KhazAkar/espws/thesis/thesis.tex

\documentclass[12pt,a4paper,oneside]{memoir}
\usepackage{polski}
\usepackage[top=2.5cm, bottom=2.5cm, left=3.5cm, right=1cm]{geometry}
\usepackage{amsmath}
\usepackage{amsfonts}
\usepackage{amssymb}
\usepackage{graphicx}
\usepackage{titling}
\usepackage{titlesec}
\usepackage{fontspec}
\usepackage{siunitx}
\usepackage{caption}
\usepackage{multirow}
\usepackage{lscape}
\usepackage[table,xcdraw]{xcolor}
\usepackage{float}
\usepackage{pdfpages}
\usepackage{listings}
\usepackage[section]{placeins}
\usepackage[
bookmarks=false,
pdfpagelabels=false,
hyperfootnotes=false,
hyperindex=false,
pageanchor=false,
hidelinks
]{hyperref}
% Wykorzystywane źródła dla tego tekstu
% Usunięcie napisu "Rozdział"
\renewcommand{\chaptername}{} 
% Konwersja znaku mikro z matematyki na tekst
\sisetup{math-micro=\text{µ},text-micro=µ} 
% Ustawienie wcięć w paragrafach
% Ustawienie czcionki Arial 
\newfontfamily{\tytulyrozdzialow}{Arial} 
% Czionka TMR dla całego tekstu
\setmainfont{Times New Roman}
\titleformat
	{\chapter} % Formatowanie rozdziałów
	[hang] % Tekst obok liczby
	{\fontsize{14pt}{16pt}\bfseries\tytulyrozdzialow\flushleftright} % Regulacja czcionki rozdziałów
	{\chaptertitlename\ \thechapter.} % Ustawianie wyglądu nagłówków rozdziałów
	{15pt} % Odstęp między liczbą a tekstem
	{} 
\setsecheadstyle{\fontsize{13pt}{15pt}\tytulyrozdzialow\bfseries} % Ustawienie stylu dla sekcji

\definecolor{dkgreen}{rgb}{0,0.6,0}
\definecolor{gray}{rgb}{0.5,0.5,0.5}
\definecolor{mauve}{rgb}{0.58,0,0.82}

\lstset{frame=tb,
	language=C++,
	aboveskip=3mm,
	belowskip=3mm,
	showstringspaces=false,
	columns=flexible,
	basicstyle={\small\ttfamily},
	numbers=none,
	numberstyle=\tiny\color{gray},
	keywordstyle=\color{blue},
	commentstyle=\color{dkgreen},
	stringstyle=\color{mauve},
	breaklines=true,
	breakatwhitespace=true,
	tabsize=3
}
\begin{document}
\renewcommand{\maketitle}
{
	\centering
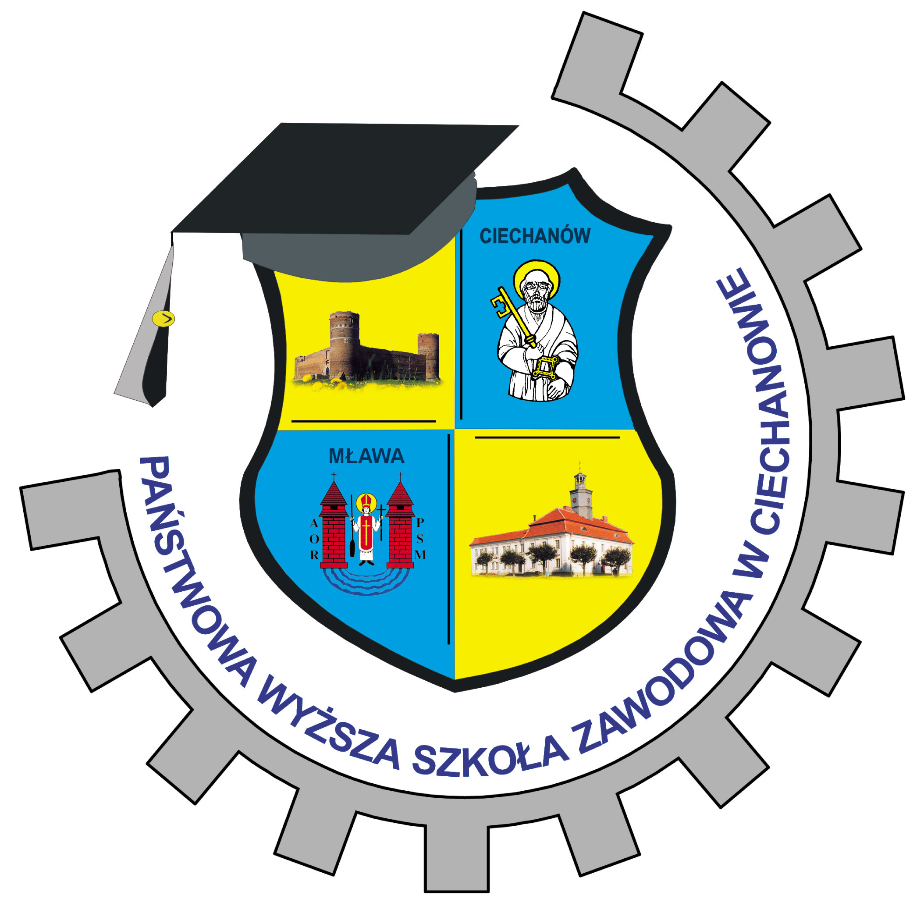
[picture p1: thesis/images/logo.jpg]
	\par\vspace{1cm}
	{\scshape\LARGE Kierunek: Elektronika i Telekomunikacja\\ Specjalność: Teleinformatyka \par}
	\vspace{1cm}
	{\scshape\Large Praca dyplomowa inżynierska\par}
	\vspace{1.5cm}
	{\huge\bfseries Stacja meteorologiczna oparta o ESP8266\par}
	\vspace{2cm}
	{\Large\itshape Damian Zaręba\\Nr albumu 8389\par}
	\vfill
	Promotor:\par
	dr inż. Tadeusz Leszczyński
	\vfill
	
	% Dół strony
	{\large Mława 2019r. \par}
}
\maketitle
\thispagestyle{empty}
\newpage
{\tytulyrozdzialow \tableofcontents}
\newpage
\flushleftright
\chapter{Wstęp}
	\hspace{\parindent} Celem pracy jest zaprojektowanie i zrealizowanie stacji meteorologicznej opartej o mikroprocesor ESP8266, złożonej z kilku modułów. Aby zrealizować założony cel, zrealizowane zostały następujące zadania:
	\begin{itemize}{}{}
		\item Zaprojektowanie i wykonanie płyty głównej z mikrokontrolerem ESP8266EX dla przetwarzania informacji z sensorów oraz sterowania zasilaniem całego urządzenia;
		\item Zaimplementowanie sensora firmy BOSCH o nazwie BME280, który służy do odczytu temperatury, ciśnienia i wilgotności powietrza;
		\item Zaimplementowanie czujnika firmy PLANTOWER o nazwie PMS7003, który mierzy ilość pyłu zawieszonego w powietrzu, o wielkości PM1.0 oraz PM10, mierzone w \si\micro g/m$^{3}$.
	\end{itemize}
	\par W kolejnych rozdziałach pracy przedstawiono schemat blokowy urządzenia oraz ogólny opis poszczególnych modułów wykorzystanych do zbudowania tego urządzenia, wliczając w to charakterystyki głównych komponentów dla każdego modułu. Udokumentowane zostało m.in. konfiguracja środowiska, które zostało wykorzystana do stworzenia tego projektu.
	\par Przeanalizowano szczegółowo schemat urządzenia, a konkretnie płyty głównej, sekcji zasilania dla wykorzystanych sensorów oraz innych elementów niezbędnych do realizacji projektu. Poddana dokładnej analizie będzie każda z części schematu, takie jak sekcja zasilania czy połączeniowa między płytą główną a sensorami.
	\par  W przedostatnim rozdziale przedstawiono i opisano algorytmy oraz kod źródłowy programu sterującego stacją pogodową oraz omówiono protokoły komunikacyjne. Wykonuje on wiele zadań, m.in. odczytuje dane z sensorów czy kontroluje układy zasilania poszczególnych części.
	\par W ostatnim rozdziale przedstawione zostały wyniki badań wykonanego modelu stacji pogodowej.

\chapter{Elementy składowe projektu} 
\section{ESP8266EX}
\par ESP8266EX to mikroukład z pełnym stosem TCP/IP oraz mikrokontrolerem wyprodukowanym przez Espressif w Szanghaju, Chiny.\\
Istnieje jego odmiana o nazwie ESP8285 z 1 MiB wbudowanej pamięci typu flash, co umożliwiało wykorzystanie go jako pojedynczego układu zdolnego do podłączenia się do sieci Wi-Fi, po podłączeniu zasilania. W odróżnieniu od rodziny mikrokontrolerów AVR nie może być zasilany napięciem 5V, jedynie 3.3 wolta.\\
\begin{figure}[h]
	\centering
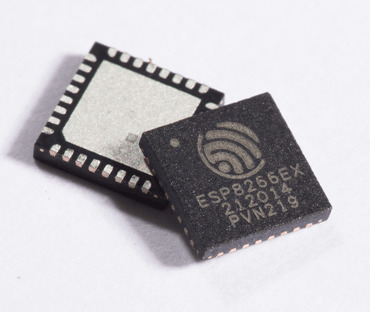
[picture p2: thesis/images/esp8266ex.jpg]
	
	{\tytulyrozdzialow \footnotesize \caption[ESP8266EX]{Zdjęcie przedstawiające układ ESP8266EX}
	\caption*{\textit{Źródło: \cite{esp8266chip}}}}
\end{figure}\\
\par ESP8266EX \cite{esp8266wiki} posiada 32 bitowy procesor oparty o rdzeń Xtensa Diamond Standard 106Micro (LX106) firmy Tensillica o nominalnej wartości zegara wynoszącym 80 MHz. Charakteryzuje się on następującymi funkcjami:
\begin{itemize}
	\item 16 pinów GPIO
	\item SPI
	\item I$^2$C (programowa implementacja)
	\item I$^2$S z funkcją Direct Memory Access (współdzieli piny z GPIO)
	\item UART na wyznaczonych pinach GPIO oraz dodatkowy UART na GPIO2 służący jedynie do wysyłania danych
	\item 10-bitowy ADC oparty o sukcesywną aproksymację.
	\item Wbudowana obsługa Wi-Fi o standardach b/g/n według IEEE 802.11 z wbudowanym przełącznikiem TR,LNA,Balunem, wzmacniaczem mocy oraz siecią dopasowującą oraz możliwością podłączenia się lub tworzenia sieci z zabezpieczeniami WEP lub WPA/WPA2
\end{itemize}
\par Pamięć ulotna tego mikrokontrolera jest podzielona w następujący sposób :
\begin{itemize}
	\item 32 KiB RAM dla instrukcji
	\item 32 KiB RAM typu cache dla instrukcji
	\item 80 KiB RAM dla danych użytkownika
	\item 16 KiB RAM typu ETS dla danych "systemowych"
\end{itemize}
\par Obsługuje pamięć nieulotną typu flash po protokole SPI do pojemności 16 MiB, choć zazwyczaj korzysta się z pamięci o rozmiarach 512 KiB lub 4 MiB.\\
\begin{figure}[h]
	\centering
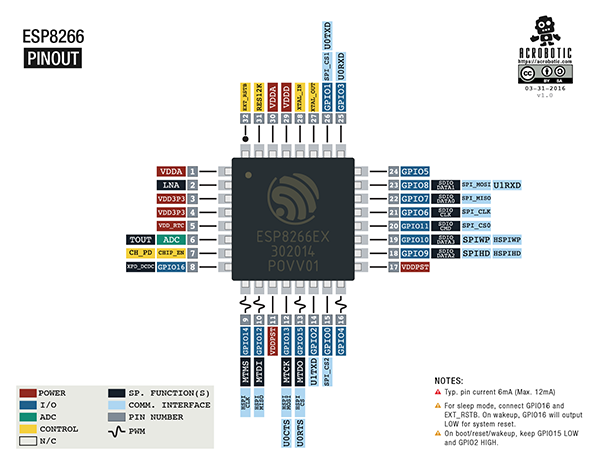
[picture p3: thesis/images/esp8266_pinout.png]
	
	{\tytulyrozdzialow \footnotesize \caption[ESP8266EX - opis wyprowadzeń]{Zdjęcie przedstawiające wyprowadzenia dla układu ESP8266EX}
	\caption*{\textit{Źródło: \cite{esp8266pinout}}}}
\end{figure}
\newpage
Układ ESP8266EX posiada kilka linii zasliania:
\begin{itemize}
	\item 2x VDDA (Zasilanie sekcji analogowej)- 2.5 wolt do 3.6 wolt
	\item VDDD (To samo, co VDDA) - 2.5 wolt do 3.6 wolt.
	\item 2x VDD3P3 (Zasilanie wzmacniacza sygnału Wi-Fi) - 2.5 wolt do 3.6 wolt.
	\item 2x VDDPST (Zasilanie sekcji cyfrowej i wejść/wyjść) - 1.8 wolt do 3.6 wolt.
\end{itemize}
\par Używa się pinów GPIO2, GPIO0 oraz GPIO15/MTDO dla ustawienia trybu uruchamiania układu.
\\[10pt]
\begin{table}[!h]
\centering
\resizebox{10cm}{!}{%
	\begin{tabular}{|
			>{\columncolor[HTML]{EFEFEF}}c |c|c|c|}
		\hline
		\cellcolor[HTML]{96FFFB} & \cellcolor[HTML]{EFEFEF}\textbf{GPIO0} & \cellcolor[HTML]{EFEFEF}\textbf{GPIO2} & \cellcolor[HTML]{EFEFEF}\textbf{GPIO15} \\ \hline
		\textbf{\begin{tabular}[c]{@{}c@{}}Tryb \\ programowania\end{tabular}} & L & H & L \\ \hline
		\textbf{\begin{tabular}[c]{@{}c@{}}Uruchamianie z\\ pamięci flash\end{tabular}} & H & H & L \\ \hline
		\textbf{\begin{tabular}[c]{@{}c@{}}Uruchamianie z\\ karty SD\end{tabular}} & X & X & H \\ \hline
	\end{tabular}%
}
	{\tytulyrozdzialow \footnotesize \caption[ESP8266EX - tryby uruchamiania]{Tabela przedstawiająca tryby uruchamiania dla układu ESP8266EX}
	\caption*{\textit{Źródło: \cite{esp8266datasheet}}}}
\end{table}\\
\newpage
\par ESP8266EX obsługuje 14 kanałów w łączności Wi-Fi
\begin{table} [!h]
\centering
\resizebox{6cm}{!}{%
	\begin{tabular}{|c|c|}
		\hline
		\rowcolor[HTML]{EFEFEF} 
		\textbf{\begin{tabular}[c]{@{}c@{}}Numer\\ kanału\end{tabular}} & \textbf{\begin{tabular}[c]{@{}c@{}}Częstotliwość\\ {[}MHz{]}\end{tabular}} \\ \hline
		1 & 2412 \\ \hline
		2 & 2417 \\ \hline
		3 & 2422 \\ \hline
		4 & 2427 \\ \hline
		5 & 2432 \\ \hline
		6 & 2437 \\ \hline
		7 & 2442 \\ \hline
		8 & 2447 \\ \hline
		9 & 2452 \\ \hline
		10 & 2457 \\ \hline
		11 & 2462 \\ \hline
		12 & 2467 \\ \hline
		13 & 2472 \\ \hline
		14 & 2484 \\ \hline
	\end{tabular}%
}
	{\tytulyrozdzialow \footnotesize \caption[ESP8266EX - kanały Wi-Fi]{Tabela przedstawiająca dostępne kanały łączności Wi-Fi dla układu ESP8266EX}
	\caption*{\textit{Źródło: \cite{esp8266datasheet}}}}
\end{table}\\
\newpage
\par Maksymalny pobór prądu przez sam układ, nie licząc łączności Wi-Fi wynosi 12mA.
Pobór wzrasta w zależności od mocy transmisji lub odbioru pakietów za pomocą Wi-Fi. Pomiary były wykonane dla napięcia 3 wolt w temperaturze 25$^°$C. Wszystkie pomiary przesyłu danych były bazowane na 50\% długości cyklu
\begin{table}[!h]
\centering
\resizebox{15cm}{!}{%
	\begin{tabular}{|
			>{\columncolor[HTML]{EFEFEF}}c |c|c|c|c|}
		\hline
		\textbf{\begin{tabular}[c]{@{}c@{}}Parametry \\ łączności\end{tabular}} & \cellcolor[HTML]{EFEFEF}\textbf{Minimalny} & \cellcolor[HTML]{EFEFEF}\textbf{Typowy} & \cellcolor[HTML]{EFEFEF}\textbf{Maksymalny} & \cellcolor[HTML]{EFEFEF}\textbf{Jednostka} \\ \hline
		\begin{tabular}[c]{@{}c@{}}TX 802.11b\\ CCK 11 Mbps\\ $P_{OUT}$ =\\ +15 dBm\end{tabular} & - & 170 & - & mA \\ \hline
		\begin{tabular}[c]{@{}c@{}}TX 802.11g\\ OFDM 54 Mbps\\ $P_{OUT}$=\\ +17 dBm\end{tabular} & - & 140 & - & mA \\ \hline
		\begin{tabular}[c]{@{}c@{}}TX 802.11n\\ MCS7\\ $P_{OUT}$ =\\ +13 dBm\end{tabular} & - & 120 & - & mA \\ \hline
		\begin{tabular}[c]{@{}c@{}}RX 802.11b\\ 1024 bajtów\\ -80 dBm\end{tabular} & - & 50 & - & mA \\ \hline
		\begin{tabular}[c]{@{}c@{}}RX 802.11g\\ 1024 bajtów\\ -70 dBm\end{tabular} & - & 56 & - & mA \\ \hline
		\begin{tabular}[c]{@{}c@{}}RX 802.11n\\ 1024 bajtów\\ -65 dBm\end{tabular} & - & 56 & - & mA \\ \hline
	\end{tabular}%
}
	{\tytulyrozdzialow \footnotesize \caption[ESP8266EX - pobór mocy przy łączności Wi-Fi]{Tabela przedstawiająca pobór mocy dla łączności Wi-Fi przez ESP8266EX}
	\caption*{\textit{Źródło: \cite{esp8266datasheet}}}}
\end{table}
\newpage
\section{BME280}
BME280 to sensor temperatury, wilgotności i ciśnienia wykonany przez firmę Bosch.
Jego rozmiary to 2.5 milimetra na 2.5 milimetra w obudowie typu LGA (Land Grid Array).
Komunikuje się z mikrokontrolerem za pomocą protokołu I$^2$C (Do 3.4 MHz) lub SPI (3 lub 4 przewodowego, do 10 MHz)
\begin{figure} [h]
	\centering
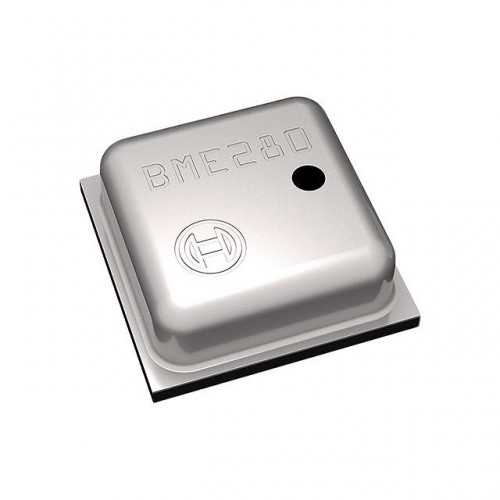
[picture p4: thesis/images/bme280.jpg]
	
	{\tytulyrozdzialow \footnotesize \caption[BME280]{Zdjęcie przedstawiające układ BME280}}
	\caption*{\textit{Źródło: \cite{bme280chip}}}
\end{figure}\\
Zasilany jest w projekcie napięciem 3.3V, choć jego specyfikacja podaje, że pin zasilania VDD samego układu toleruje napięcia od 1.71 wolt do 3.6 wolt, a pin zasilania wejść/wyjść VDDIO od 1.2 wolt do 3.6 wolt.\\*
\begin{figure} [h]
	\centering
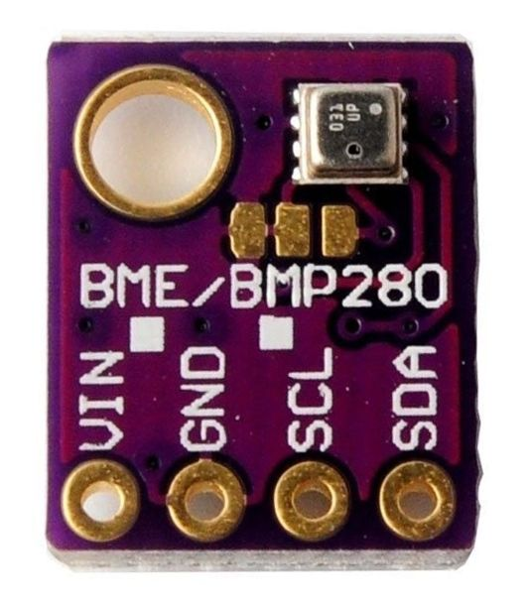
[picture p5: thesis/images/bme280-mod.jpg]
	
	{\tytulyrozdzialow \footnotesize \caption[BME280 - Moduł]{Zdjęcie przedstawiające moduł zawierający BME280, komunikujący się przez protokół I$^2$C}}
	\caption*{\textit{Źródło: \cite{bme280module}}}
\end{figure}\\
\newpage
Pobiera w zastosowanej aplikacji około 3.6µA, czyli pomiaru wilgotności, ciśnienia i temperatury z częstotliwością 1Hz, choć może być niższy, ponieważ pomiary będą dokonywane rzadziej, około co pół godziny lub godzinę, w zależności od wymagań. Będzie możliwość ustawienia tego w kodzie źródłowym programu dla tej aplikacji.\\[10pt]
Kluczowe parametry sensora wilgotności:
\begin{itemize}
	\item Czas odpowiedzi ($\tau_{63\%}$) wynosi 1 sekundę
	\item Tolerancja dla dokładności pomiaru wynosi ±3 \% relatywnej wilgotności
	\item Histereza pomiaru wynosi ±1 \% relatywnej wilgotności
\end{itemize}
Kluczowe parametry części pomiarowej dla ciśnienia:
\begin{itemize}
	\item Średni poziom szumów wynosi 0.2 Pa, co jest odpowiednkiem dla 1.7 cm
	\item Współczynnik odchylenia temperaturowego wynosi ±1.5 Pa/K, co jest równoważne dla ±12.6 cm przy zmianie temperatury o 1$^°$C
\end{itemize}
\newpage
\section{PMS7003}
Sensor PMS7003 służy do pomiaru ilości cząsteczek w powietrzu o gradiacji PM1.0, PM2.5 oraz PM10 (odpowiednio: cząsteczki o średnicy około 1µm, 2.5µm oraz 10µm). Powszechnie korzyta się z niego do pomiaru jakości powietrza. Wykorzystuje on do tego laserowy czujnik pyłków.
\begin{figure}[h]
	\centering
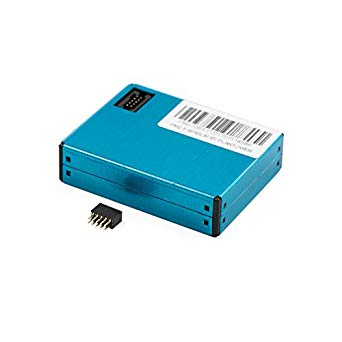
[picture p6: thesis/images/pms7003.jpg]
	
	{\tytulyrozdzialow \footnotesize \caption[PMS7003] {Zdjęcie przedstawiające moduł PMS7003, komunikujący się przez protokół UART}}
	\caption*{\textit{Źródło: \cite{pms7003module}}}
\end{figure}\\
Czujnik ten charakteryzuje się następującymi parametrami:
\begin{itemize}
	\item Pojedynczy czas odpowiedzi wynosi mniej niż 1s
	\item Całkowity czas odpowiedzi wynosi do 10 sekund
	\item Zasilany jest napięciem 5 wolt
	\item Pobór prądu podczas pomiarów wynosi do 100 mA
	\item Stały pobór prądu, kiedy czujnik nie wykonuje pomiaru wynosi do 200 μA
	\item Napięcie operacyjne dla przesyłu i odbioru danych to 3.3 wolta.
	\item Pracuje w temperaturze od -10 do +60 stopni Celcjusza.
	\item "Pojemność" czujnika wynosi 0.1L
\end{itemize}
\begin{figure}[ht]
	\centering
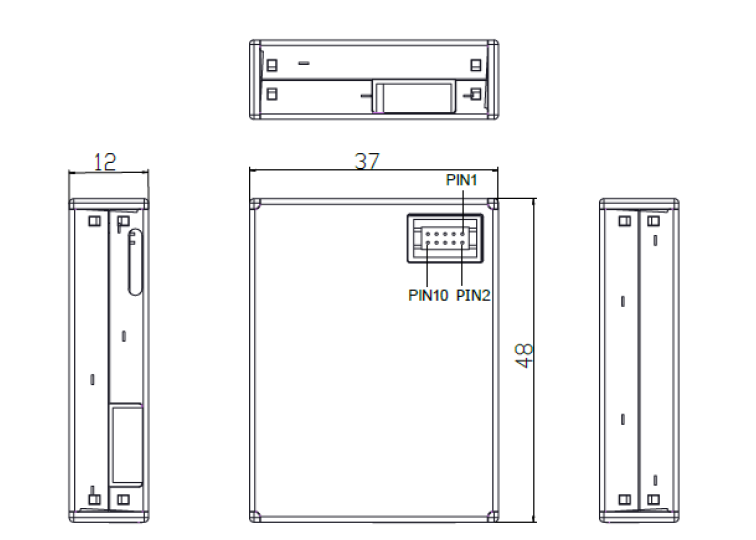
[picture p7: thesis/images/pms7003-pinout.png]
	
	{\tytulyrozdzialow \footnotesize \caption[PMS7003 - pinout] {Zdjęcie przedstawiające wyprowadzenia czujnika PMS7003}
	\caption*{\textit{Źródło: \cite{pms7003datasheet}}}}
\end{figure}
\newpage
Lista wyprowadzeń tego sensora jest następująca:
\begin{table}[h]
	\centering
	\resizebox{10cm}{!}{%
	\begin{tabular}{|c|c|c|}
		\hline
		\multicolumn{3}{|c|}{\cellcolor[HTML]{EFEFEF}\textbf{Wyprowadzenia PMS7003}} \\ \hline
		Pin 1 & VCC & Zasilanie 5V \\ \hline
		Pin 2 & VCC & Zasilanie 5V \\ \hline
		Pin 3 & GND & Masa zasilania \\ \hline
		Pin 4 & GND & Masa zasilania \\ \hline
		Pin 5 & RESET & Pin resetu modułu \\ \hline
		Pin 6 & NC & - \\ \hline
		Pin 7 & RX & Pin odbierania danych \\ \hline
		Pin 8 & NC & - \\ \hline
		Pin 9 & TX & Pin wysyłania danych \\ \hline
		Pin 10 & SET & \begin{tabular}[c]{@{}c@{}}Stan wysoki - normalna operacja\\ Stan niski - uśpienie układu\end{tabular} \\ \hline
	\end{tabular}%
}
	{\tytulyrozdzialow \footnotesize \caption[PMS7003 - Lista wyprowadzeń] {Tabela przedstawiająca listę wyprowadzeń modułu PMS7003}}
	\caption*{\textit{Źródło: \cite{pms7003datasheet}}}
\end{table}
\newpage
\chapter{Wykorzystane protokoły komunikacyjne}
\section{I$^2$C}
\par I$^2$C \cite{i2cwiki} to protokół szeregowy zaprojektowany przez firmę Phillips Semiconductor, która dziś działa jako NXP Semiconductors w 1982 roku. Ma możliwość podpięcia wielu urządzeń w trybie \textit{Master} oraz w trybie \textit{Slave}. Istnieją dwie dodatkowe wersje I$^2$C - SMBus (System Management Bus), wykorzystywany w komputerach klasy PC do zarządzania podzespołami oraz PMBus (Power Management Bus) - do kontroli urządzeń związanych z zasilaniem. 
\par Wykorzystuje on dwie obustronne linie z otwartym kolektorem lub otwartym drenem, Serial Data Line (SDA) i Serial Clock Line (SCL), z rezystorami podiągającymi do zasilania.Zazwyczaj używa się napięć +5V lub +3.3V, ale inne napięcia są również dozwolone.
\par Magistrala I$^2$C posiada kilka trybów prędkości:
\begin{itemize}
	\item Low-speed - 10 kbit/s
	\item Standard - 100 kbit/s
	\item Fast - 400 kbit/s
	\item Fast mode plus (Fm+) - 1 Mbit/s
	\item High speed - 3.4 Mbit/s
\end{itemize}
\par Z tych najszybszych korzysta się w systemach wbudowanych a nie w komputerach osobistych.\\
\par Magistrala I$^2$C posiada dwie ważne cechy - rozszerzanie zegara (Clock Stretching) oraz Arbitraż (Arbitation). 
Rozszerzanie zegara polaga na tym, że urządzenie typu \textit{Slave} może utrzymywać linię zegara SCL w stanie niskim po otrzymaniu lub wysłaniu bajtu informacji, która wskazuje, że nie jest jeszcze gotowe do przetwarzania kolejnej porcji danych. Urządzenie typu \textit{Master} komunikujące się z danym modułem nie może wtedy zakończyć transmisji tylko musi czekać aż linia zegara SCL będzie w stanie wysokim. Jest to jedyna sytuacja, gdzie urządzenie typu \textit{Slave} ma kontrolę nad linią zegara. Urządzenie typu \textit{Master} musi odczekać dodatkowe 4 μs po prześciu linii SCL w stan wysoki zanim będzie mógł podciągnąć linię zegara do stanu niskiego.
\par Magistrala I$^2$C posiada deterministyczny system arbitrażu. Arbitraż polega na tym, że każde urządzenie typu \textit{Master} monitoruje linię, wyszukując bitów START i STOP i nie zacznie komunikacji, póki linie są zajęte przez inne urządzenia typu \textit{Master}. Jednakże, dwa urządzenia typu \textit{Master} mogą zacząć transmisję w tym samym czasie - wtedy następuje arbitraż. Każdy transmiter sprawdza poziom linii danych (SDA) i porównuje do oczekiwanego; jeśli się nie zgadza to urządzenie transmitujące traci arbitrację i wyłącza się z danej interakcji z protokołem I$^2$C.
\newpage
\begin{table}[!h]
	\centering
	\resizebox{\textwidth}{!}{%
		\begin{tabular}{cccccc}
			\multicolumn{6}{c}{Status zajętości magistrali oraz bitów START i STOP.} \\ \hline
			\rowcolor[HTML]{EFEFEF} 
			\multicolumn{1}{|c|}{\cellcolor[HTML]{EFEFEF}\textbf{Typ}} & \multicolumn{1}{c|}{\cellcolor[HTML]{EFEFEF}\textbf{\begin{tabular}[c]{@{}c@{}}Linia Nieaktywna \\ (N)\end{tabular}}} & \multicolumn{1}{c|}{\cellcolor[HTML]{EFEFEF}\textbf{\begin{tabular}[c]{@{}c@{}}Start \\ (S)\end{tabular}}} & \multicolumn{1}{c|}{\cellcolor[HTML]{EFEFEF}\textbf{\begin{tabular}[c]{@{}c@{}}Oczekiwanie\\ (I)\end{tabular}}} & \multicolumn{1}{c|}{\cellcolor[HTML]{EFEFEF}\textbf{\begin{tabular}[c]{@{}c@{}}Stop\\ (P)\end{tabular}}} & \multicolumn{1}{c|}{\cellcolor[HTML]{EFEFEF}\textbf{\begin{tabular}[c]{@{}c@{}}Rozszerzanie zegara\\ (CS)\end{tabular}}} \\ \hline
			\multicolumn{1}{|c|}{\cellcolor[HTML]{EFEFEF}\textbf{Opis}} & \multicolumn{1}{c|}{Arbitraż wolny do zajęcia} & \multicolumn{1}{c|}{\begin{tabular}[c]{@{}c@{}}Zajmowanie linii\\ (Master)\end{tabular}} & \multicolumn{1}{c|}{\begin{tabular}[c]{@{}c@{}}Linia zajęta\\ (Master)\end{tabular}} & \multicolumn{1}{c|}{\begin{tabular}[c]{@{}c@{}}Zwalnianie linii\\ (Master)\end{tabular}} & \multicolumn{1}{c|}{\begin{tabular}[c]{@{}c@{}}Zastopowanie\\ (Slave)\end{tabular}} \\ \hline
			\multicolumn{1}{|c|}{\cellcolor[HTML]{EFEFEF}\textbf{SDA}} & \multicolumn{1}{c|}{Podciąganie pasywne} & \multicolumn{1}{c|}{\textbf{\begin{tabular}[c]{@{}c@{}}Zbocze opadające\\ (Master)\end{tabular}}} & \multicolumn{1}{c|}{\textbf{\begin{tabular}[c]{@{}c@{}}Stan niski\\ (Master)\end{tabular}}} & \multicolumn{1}{c|}{\textbf{\begin{tabular}[c]{@{}c@{}}Zbocze wzrastające\\ (Master)\end{tabular}}} & \multicolumn{1}{c|}{\begin{tabular}[c]{@{}c@{}}Nie ma \\ znaczenia\end{tabular}} \\ \hline
			\multicolumn{1}{|c|}{\cellcolor[HTML]{EFEFEF}\textbf{SCL}} & \multicolumn{1}{c|}{Podciąganie pasywne} & \multicolumn{1}{c|}{Podciąganie pasywne} & \multicolumn{1}{c|}{Pasywne podciąganie} & \multicolumn{1}{c|}{Pasywne podciąganie} & \multicolumn{1}{c|}{\textbf{\begin{tabular}[c]{@{}c@{}}Stan niski\\ (Slave)\end{tabular}}} \\ \hline
		\end{tabular}%
	}
	{\tytulyrozdzialow \footnotesize \caption[I$^2$C - Stany zajętości magistrali] {Tabela przedstawiająca stany zajętości linii w magistrali I$^2$C}}
	\caption*{\textit{Źródło: \cite{i2cwiki}}}
\end{table}
\begin{table}[!h]
	\centering
	\resizebox{1.05\textwidth}{!}{%
\begin{tabular}{|c|c|c|c|c|c|c|}
	\hline
	\rowcolor[HTML]{EFEFEF} 
	\cellcolor[HTML]{EFEFEF} & \multicolumn{2}{c|}{\cellcolor[HTML]{EFEFEF}\textbf{\begin{tabular}[c]{@{}c@{}}Wysłanie jednego bitu danych (1) (0)\\ (Linia SDA jest ustawiona po SCL w celu uniknięcia wykrycia fałszywego stanu linii)\end{tabular}}} & \multicolumn{2}{c|}{\cellcolor[HTML]{EFEFEF}\textbf{\begin{tabular}[c]{@{}c@{}}Odpowiedź odbiorcy za pomocą bitu ACK\\ (Bajt odebrany od nadawcy)\end{tabular}}} & \multicolumn{2}{c|}{\cellcolor[HTML]{EFEFEF}\textbf{\begin{tabular}[c]{@{}c@{}}Odpowiedź odbiorcy za pomocą bitu NACK\\ (Bajt nie odebrany od nadawcy\end{tabular}}} \\ \cline{2-7} 
	\rowcolor[HTML]{EFEFEF} 
	\multirow{-2}{*}{\cellcolor[HTML]{EFEFEF}\textbf{Typ}} & \textbf{Ustawienie bitów (Bs)} & \textbf{Gotowość do próbkowania (Bx)} & \textbf{Ustawienie bitów (Bs)} & \textbf{ACK (A)} & \textbf{Ustawienie bitów (Bs)} & \textbf{NACK(A')} \\ \hline
	\cellcolor[HTML]{EFEFEF}\textbf{Opis} & Nadawca ustawia bit (Master/Slave) & Odbiora próbkuje bit (Master/Slave) & \begin{tabular}[c]{@{}c@{}}Nadawca ustawia stan\\ wysokiej impedancji\end{tabular} & \begin{tabular}[c]{@{}c@{}}Nadawca widzi linię SDA\\ jako w stanie niskim\end{tabular} & \begin{tabular}[c]{@{}c@{}}Nadawca ustawia stan\\ wysokiej impedancji\end{tabular} & \begin{tabular}[c]{@{}c@{}}Nadawca widzi \\ stan wysoki\end{tabular} \\ \hline
	\cellcolor[HTML]{EFEFEF}\textbf{SDA} & Ustawia bit (Po opadnięciu SCL) & Odbiera bit (Po wzroście SCL) & \multicolumn{2}{c|}{\begin{tabular}[c]{@{}c@{}}Utrzymane w stanie niskim \\ (Po opadnięciu SCL)\end{tabular}} & \multicolumn{2}{c|}{\begin{tabular}[c]{@{}c@{}}Sterowane stanem wysokim \\ (Lub pasywnie wysokim) przez odbiorcę\\ (Po opadnięciu SCL)\end{tabular}} \\ \hline
	\cellcolor[HTML]{EFEFEF}\textbf{SCL} & \textbf{Opadające zbocze (Master)} & \textbf{Wzrastające zbocze (Master)} & \textbf{Opadające zbocze (Master)} & \textbf{Wzrastające zbocze (Master)} & \textbf{Opadające zbocze (Master)} & \textbf{Wzrastające zbocze (Master)} \\ \hline
\end{tabular}%
}
	{\tytulyrozdzialow \footnotesize \caption[I$^2$C - Stany magistrali przy przesyle danych] {Tabela przedstawiająca stany linii w magistrali I$^2$C przy wymianie informacji między odbiorcą a nadawcą}}
	\caption*{\textit{Źródło: \cite{i2cwiki}}}
\end{table}
Magistrala I$^2$C posiada 7 bitową adresację oraz 10 bitową adresację, która jest wykorzystywana jako rozszerzenie podstawowej, 7 bitowej adresacji. 7 bitowa adresacja posiada 2 zarezerwowane grupy adresów - \textit{0000 XXX} oraz \textit{1111 XXX}:
\begin{itemize}
	\item \textit{0000 000 0} - Generalne odwołanie
	\item \textit{0000 000 1} - bajt START
	\item \textit{0000 001 X} - Adres CBUS
	\item \textit{0000 010 X} - Zarezerwowane dla innego formatu magistrali
	\item \textit{0000 011 X} - Zarezerwowane na przyszły użytek
	\item \textit{0000 1XX X} - Kod trybu High Speed
	\item \textit{1111 1XX 1} - Kod identyfikacyjny urządzenia
	\item \textit{1111 0XX X} - 10 bitowa adresacja urządzenia typu \textit{Slave}
\end{itemize}
7-bitowa adresacja składa się z 7 bitów identyfikacji oraz ósmego bitu - oznaczenia zapisu/odczytu danych. Długość części MSB to 4 bity, a LSB - 3 bity.
\begin{table}[!h]
	\centering
	\resizebox{\textwidth}{!}{%
		\begin{tabular}{|c|c|c|c|c|c|c|c|c|c|c|c|c|}
			\hline
			\cellcolor[HTML]{EFEFEF}\textbf{Pole} & \cellcolor[HTML]{EFEFEF}\textbf{S} & \multicolumn{7}{c|}{Adres I$^2$C} & R/W & A & Sekwencje danych I$^2$C & P \\ \hline
			\rowcolor[HTML]{EFEFEF} 
			\textbf{Typ} & \cellcolor[HTML]{EFEFEF} & \multicolumn{8}{c|}{\cellcolor[HTML]{EFEFEF}\textbf{Pierwszy bajt}} & \cellcolor[HTML]{EFEFEF} & \cellcolor[HTML]{EFEFEF} & \cellcolor[HTML]{EFEFEF} \\ \cline{1-1} \cline{3-10}
			\rowcolor[HTML]{EFEFEF} 
			\textbf{Pozycja bitu w bajcie X} & \cellcolor[HTML]{EFEFEF} & \textbf{7} & \textbf{6} & \textbf{5} & \textbf{4} & \textbf{3} & \textbf{2} & \textbf{1} & \textbf{0} & \cellcolor[HTML]{EFEFEF} & \cellcolor[HTML]{EFEFEF} & \cellcolor[HTML]{EFEFEF} \\ \cline{1-1} \cline{3-10}
			\rowcolor[HTML]{EFEFEF} 
			\textbf{Pozycja 7-bitowego adresu} & \cellcolor[HTML]{EFEFEF} & \textbf{7} & \textbf{6} & \textbf{5} & \textbf{4} & \textbf{3} & \textbf{2} & \textbf{1} & \textbf{} & \cellcolor[HTML]{EFEFEF} & \cellcolor[HTML]{EFEFEF} & \cellcolor[HTML]{EFEFEF} \\ \cline{1-1} \cline{3-10}
			Opis & \multirow{-4}{*}{\cellcolor[HTML]{EFEFEF}\textbf{START}} & \multicolumn{4}{c|}{MSB} & \multicolumn{3}{c|}{LSB} & \begin{tabular}[c]{@{}c@{}}0 = Zapis\\ 1 = Odczyt\end{tabular} & \multirow{-4}{*}{\cellcolor[HTML]{EFEFEF}\textbf{ACK}} & \multirow{-4}{*}{\cellcolor[HTML]{EFEFEF}\textbf{\begin{tabular}[c]{@{}c@{}}Kolejny bajt itd.\\ Dalsze wiadomości zapisu\\ lub odczytu idą tutaj.\end{tabular}}} & \multirow{-4}{*}{\cellcolor[HTML]{EFEFEF}\textbf{STOP}} \\ \hline
		\end{tabular}%
	}
	{\tytulyrozdzialow \footnotesize \caption[I$^2$C - Struktura 7-bitowego adresu] {Tabela przedstawiająca strukturę 7-bitowej adresacji w magistrali I$^2$C}}
	\caption*{\textit{Źródło: \cite{i2cwiki}}}
\end{table}
\newpage
10-bitowy adres jest podzielony na 2 segmenty - górny i dolny, które są poprzedzone specjalnym adresem, który komunikuje, że wykorzystywana jest 10-bitowa adresacja w magistrali - \textit{1111 0XX X}.
\begin{figure}[!h]
	\centering
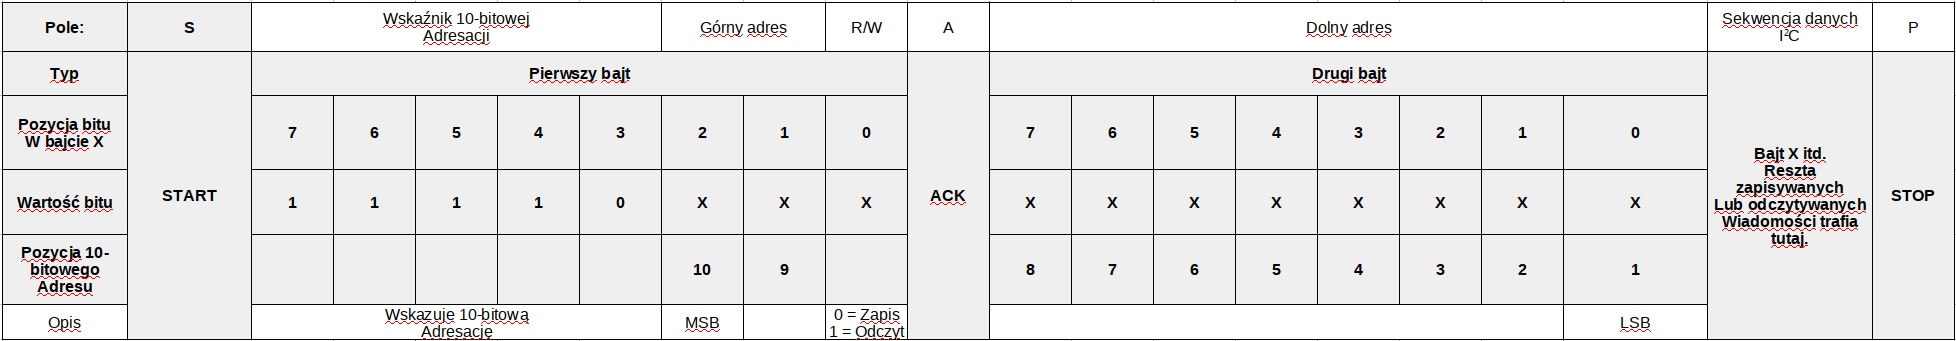
[picture p8: thesis/images/i2c-10bit-addresing.png]
	
	{\tytulyrozdzialow \footnotesize \caption[I$^2$C - Struktura 10-bitowego adresu] {Tabela przedstawiająca strukturę 10-bitowej adresacji w magistrali I$^2$C}}
	\caption*{\textit{Źródło: \cite{i2cwiki}}}
\end{figure}\\
\newpage
Przebieg czasowy protokołu I$^2$C wygląda następująco:
\begin{enumerate}
\item Przesył danych jest inicjowany za pomocą bitu START (S) zasygnalizowane przez podciągnięcie linii SDA w stan niski, kiedy linia SCL jest w stanie wysokim;
\item Linia SCL jest podciągnięta do stanu niskiego, a linia SDA ustawia poziomu pierwszych bitów danych utrzymując linię SCL w stanie niskim (cała długość niebieskiego prostokąta);
\item Dane są próbkowane (odbierane) kiedy linia SCL jest w stanie wzrastającego zbocza dla pierwszego bitu. Żeby bit był poprawny, SDA nie może zmienić swojego stanu między wzrastającym zboczem linii SCL oraz następującym opadem zbocza (cała długość zielonego prostokąta);
\item Powyższa czynność jest powtarzana dla każdego kolejnego bitu;
\item Ostatni bit jest poprzedzony pulsem zegarowym, podczas którego linia SDA jest podciągnięta do stanu niskiego do przygotowania się do bitu STOP;
\item Bit STOP (P) jest sygnałowany kiedy linia SCL wzrasta, poprzedzona wzrastaniem linii SDA.
\end{enumerate}
\begin{figure}[!h]
	\centering
	
	{\tytulyrozdzialow \footnotesize \caption[I$^2$C - Diagram czasowy] {Obrazek przedstawiający diagram czasowy w magistrali I$^2$C}}
	\caption*{\textit{Źródło: \cite{i2cwiki}}}
\end{figure}
\newpage
\section{UART}
\par UART (Universal asynchronous receiver-transmitter) \cite{uartwiki} to asynchroniczna, szeregowa magistrala komunikacyjna, w której format danych oraz prędkość przesyłu informacji jest konfigurowalna. Poziomy logiczne sygnałów oraz metody są kontrolowane przez zewnętrzną elektronikę podłączoną do kontrolera UART. Podobny protokół, USART (Universal synchronous and asynchronous receiver-transmitter) wspiera komunikację synchroniczną.
\par UART bierze bajty danych i przesyła indywidualne bity sekwencyjnie. W miejscu docelowym, urządzenie odbiorcze UART "buduje" dane na nowo z przybyłych bitów informacji w całe bajty. Każdy układ UART zawiera rejestr przesuwny, który odpowiada za przetwarzanie informacji między równoległą  a szeregową formą danych. Komunikacja może odbywać się w jednym z 3 trybów:
\begin{itemize}
	\item \textit{Simplex} - Tylko w jedną stronę, bez nadzoru dla urządzenia odbiorczego do wysyłu danych zwrotnych do urządzenia transmitującego;
	\item \textit{Half duplex} - Urządzenia zmieniają się miejscami przy przesyle danych - raz jedno wysyła, raz drugie;
	\item \textit{Full duplex} - Urządzenia wysyłają i odbierają dane w tym samym czasie.
\end{itemize}
\par W stanie oczekiwania, kiedy nie są wysyłane dane, linie są w stanie logicznym wysokim. Jest to pozostałość historyczna z telegrafów, gdzie linia była utrzymywana w stanie wysokim, żeby pokazać, iż linia i transmiter nie były uszkodzone.Każda część informacji jest opakowana jako bit START (logiczne 0), bity danych, opcjonalnie bit parzystości oraz jeden lub kilka bitów STOP.
\begin{figure}[!h]
	\centering
	
	{\tytulyrozdzialow \footnotesize \caption[UART - Diagram czasowy] {Obrazek przedstawiający diagram czasowy w magistrali UART}}
	\caption*{\textit{Źródło: \cite{uartwiki}}}
\end{figure}
\par Bit START sygnalizuje urządzenie odbiorcze o tym, że nowa częśc informacji nadchodzi. Kolejne 5 do 9 bitów, w zależności od odu który przyjęto, reprezentuje tą część danych. Jeśli bit parzystości został użyty, będzie umieszczony po wszystkich bitach danych. Kolejne 1 lub 2 bity zawsze są w oznaczonej pozycji (Logiczna jedynka) i nazwane bitem (lub bitami) STOP. Informują one moduł odbiorczy o tym, że ciąg znaków został ukończony.
\par UART składa się z kilku kluczowych elementów oraz ewentualnych, opcjonalnych dodatków, które rozszerzają możliwości magistrali w różny sposób.
Urządzenie  do obsługi protokołu UART wymaga:
\begin{itemize}
	\item Generator sygnału zegara, zazwyczaj wielokrotność prędkośći przesyłu danych dla umożliwienia próbkowania w środku czasu trwania bitu;
	\item Wejśćiowe i wyjśćiowe rejestry przesuwne;
	\item Kontrola przesyłu/odbioru danych;
	\item Logika kontrolijąca zapis/odczyt danych.
\end{itemize}
Dodatkowo, można wyposażyć protokół w dodatkowe bloki funkcyjne, takie jak:
\begin{itemize}
	\item Bufory przesyłu/odbioru danych;
	\item Bufor magistrali danych systemowych;
	\item Bufor pamięci typu FIFO (First-in, first-out);
	\item Sygnały potrzebne dla zewnętrznego kontrolera DMA (Direct Memory Access);
	\item Zintegrowana magistrala zarządzająca kontrolerem DMA.
\end{itemize}
\par UART posiada kilka specjalnych zdarzeń, które mogą wystąpić podczas transmisji. Są to:
\begin{itemize}
	\item Błąd przekroczenia (Overrun error) -Odbiornik nie może przetworzyć znaku który przybył przed kolejnym znakiem, który nadchodzi;
	\item Błąd niedociągnięcia (Underrun error) - Nadajnik skończył wysyłać dane i bufor przesyłu jest pusty;
	\item Błąd obramowania (Framing error) - Urządzenie nie "widzi" bitu STOP w oczekiwanym czasie jego występowania;
	\item Błąd parzystości (Parity error) - Bit parzystości nie zgadza się między odbiornikiem a nadajnikiem;
	\item Zerwanie transmisji (Break condition) - Wejście odbiornika jest w ,,odstępie" (Stan niski) dłużej niż przewidywany czas oczekiwania, zazwyczaj dłużej niż długość znaku.
\end{itemize}
\newpage
\chapter{Schemat funkcjonalny}
\par Zaprojektowane i wykonane urządzenie składa się z 3 głównych części - Dwóch różnych, wybieranych przez użytkownika źródeł zasilania (Zasilaczem lub baterią), sekcji zasilania mikrokontrolera i sensorów, oraz samego ESP8266EX i połączeń do wyprowadzeń dla czujników. Zasilanie jest czterokanałowe dla zapewnienia stabilności napięcia dla każdego ważnego układu w projekcie. Przełącznik pozwala na przełączanie między łądowaniem baterii a zasilaniem całej płyty głównej. Panel słoneczny jest bezpośrednio podłączony do kontrolera ładowania. 
\begin{figure}[!h]
	\centering
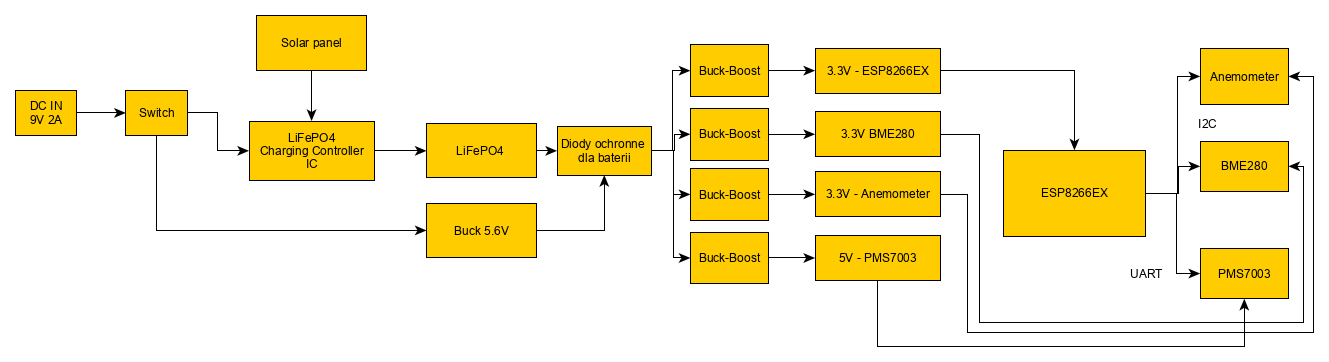
[picture p9: thesis/images/block-schematic.png]
	
	{\tytulyrozdzialow \footnotesize \caption[Schemat blokowy] {Obrazek przedstawiający schemat blokowy urządzenia}}
	\caption*{\textit{Źródło: Opracowanie własne}}
\end{figure}
\par Wykorzystano baterię LiFePO4, które pozwalają na bardziej wydajną pracę od Li-Ion czy LiPo w temperaturach poniżej zera, ponieważ jedynie tracą około 10\% pojemności niżej zera stopni Celsjusza, nie 30+ \% jak Li-Ion czy LiPo. Wykorzystano przetwornice DC-DC typu buck-boost (push-pull) dla stabilizacji napięć z baterii LiFePO4. Mimo dużej ilości zakłóceń generowanych przez przetwornice DC-DC, posiadają o wiele wyższą sprawność od liniowych kontrolerów napięć. Diody Schottky między baterią a przetwornicami uniemożliwi ładowania baterii napięciem 5.6V z kontrolera DC-DC który służy do zasilania całego układu przy odpowiednim ustawieniu przełącznika w tryb zasilania. Wybrano zasilanie 9V i 3A dla dostarczenia odpowiedniej ilości mocy zarówno do ładowania baterii, jak i do samodzielnego zasilania całego układu. Napięcie z przetwornicy podpiętej do zewnętrznego zasilania 9V i 3A wynosi 5.6V, ponieważ po wykorzystaniu diody typu Schottky napięcie nie przekracza maksymalnego dla wykorzystanych przetwornic DC-DC, które wynosi 5.5V. Konwertery napięć typu push-pull dają na wyjśćiu 3.3V dla sensorów i mikrokontrolera, oraz 5V dla czujnika cząsteczek stałych w powietrzu. Wykorzystany panel fotowoltaiczny musi być na napięcie wynoszące 12V pod obciążeniem.
\newpage
\chapter{Schemat elektryczny}
\par Schemat został podzielony na bloki funkcyjne, które zostały szczegółowo omówione podczas ich prezencji. Wykorzystane oprogramowanie do narysowania schematu oraz zaprojektowania płytki drukowanej nazywa się KiCAD \cite{kicad}. Jest to multiplatformowe, darmowe i otwartoźródłowe (FOSS) oprogramowanie do projektowania elektroniki na Windowsa, macOS i Linuksa.
\section{Ogólny przegląd}
\begin{figure}[!h]
	\centering
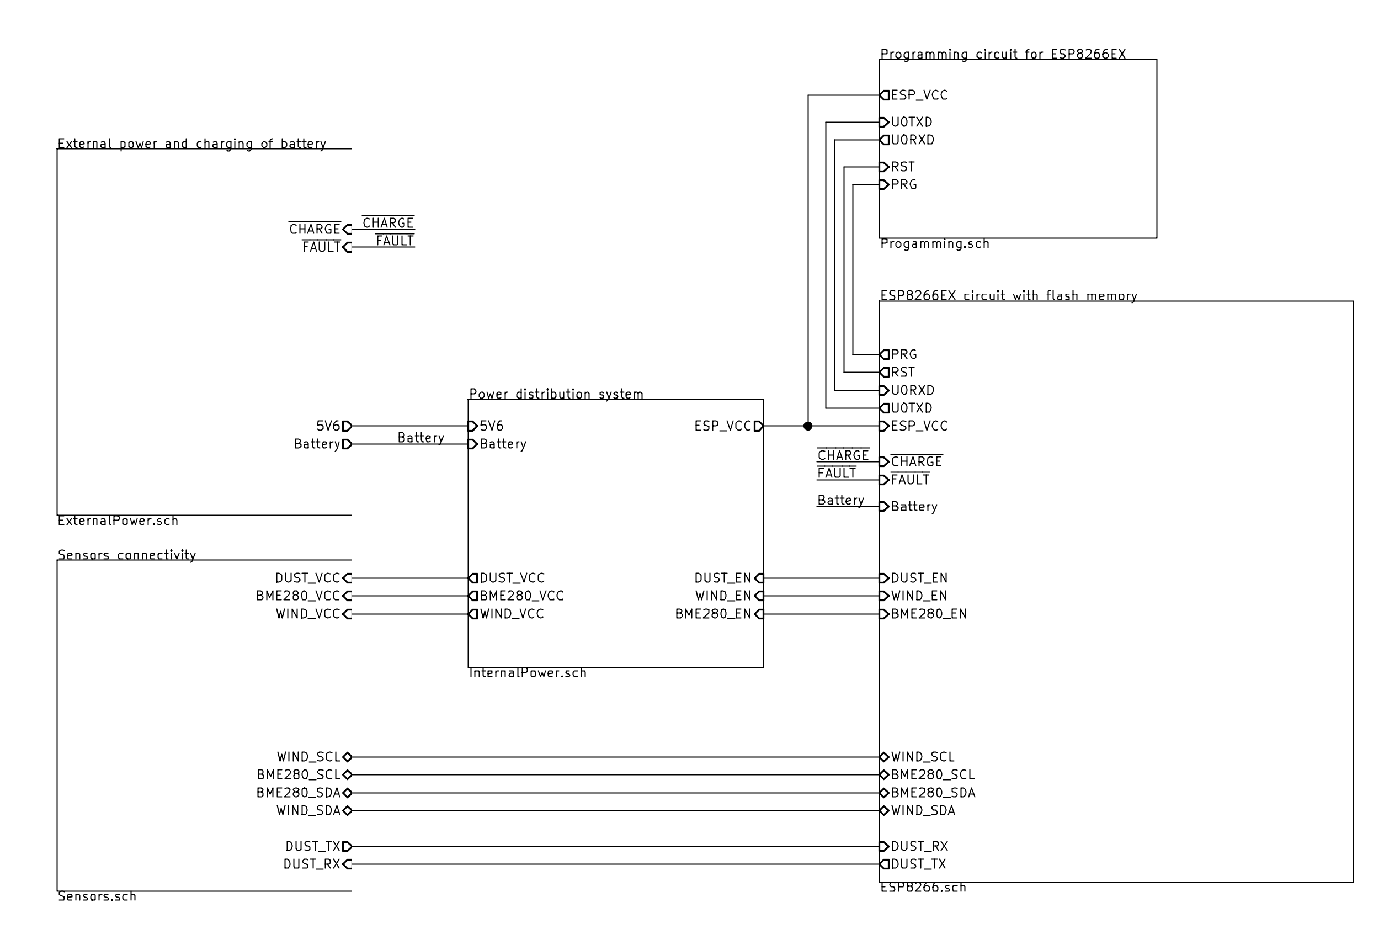
[picture p10: thesis/images/sch/sch-01.png]
	
	{\tytulyrozdzialow \footnotesize \caption[Schemat - ogólny przegląd] {Obrazek przedstawiający ogólny przegląd schematu projektu}}
	\caption*{\textit{Źródło: Opracowanie własne}}
\end{figure}
\par Przedstawiono ogólny zarys całego projektu. Jest to schemat nadrzędny. Wykorzystano tzw. schematy hierarchiczne dla uporządkowania całości oraz dodania możliwości wykorzystania powstałych ,,modułów'' w innych projektach, co znacząco przyspiesza projektowanie przyszłych urządzeń, które wykorzystują np. ESP8266EX zastosowany w tym projekcie.
\newpage
\section{Panel słoneczny}
\begin{figure}[!h]
	\centering
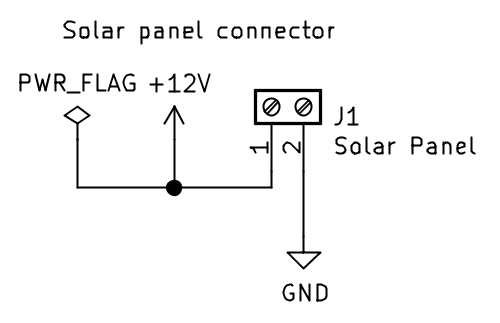
[picture p11: thesis/images/sch/sch-02.png]
	
	{\tytulyrozdzialow \footnotesize \caption[Schemat - konektor panelu słonecznego] {Obrazek przedstawiający wycinek schematu z konektorem dla panelu słonecznego }}
	\caption*{\textit{Źródło: Opracowanie własne}}
\end{figure}
\par Wykorzystano 2 pinowy konektor do podłączenia przewodów do panelu słonecznego. Zaciska się połączenie między płytką drukowaną a przewodami za pomocą śrub w konektorze, który może obsłużyć maksymalnie 300V i 18A. Oznaczono również go jako źródło zasilania dla 12V linii, prowadzącej do układu ładowania baterii LiFePO4 za pomocą energii słonecznej.
\section{Zewnętrzne źródło zasilania}
\begin{figure}[!h]
	\centering
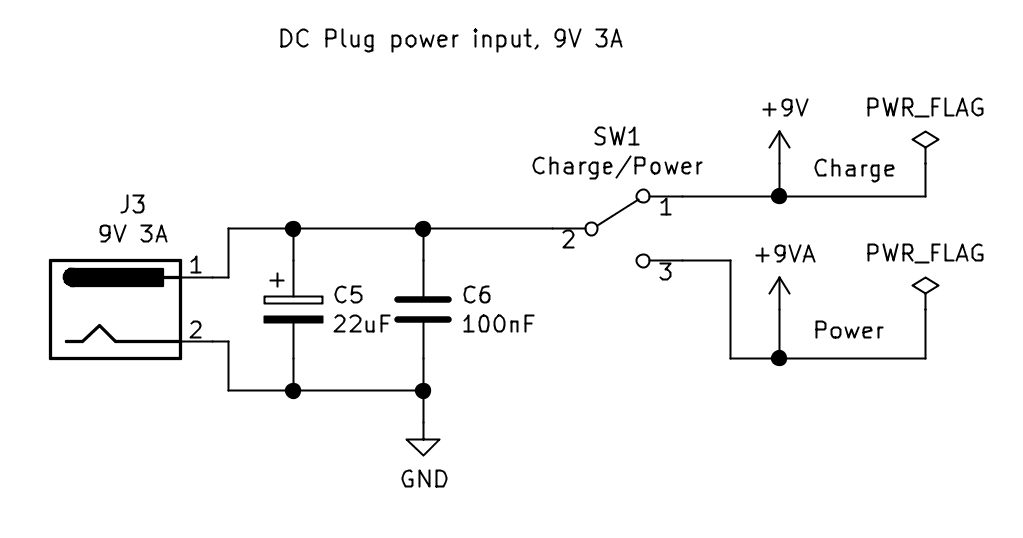
[picture p12: thesis/images/sch/sch-03.png]
	
	{\tytulyrozdzialow \footnotesize \caption[Schemat - konektor zewnętrznego ładowania/zasilania] {Obrazek przedstawiający wycinek schematu z konektorem dla zewnętrznego zasilacza do ładowania lub zasilania układu }}
	\caption*{\textit{Źródło: Opracowanie własne}}
\end{figure}
\par Zasilanie 9V 3A to standardowy, okrągły konektor typu DC, 5.5mm, przystosowany do napięć rzędu 24V i prądu rzędu 8A, z dodatkową osłoną na gniazdo. Podłączone zostały kondensatory do filtracji zasilania, a po nich - przełącznik do wyboru między zasilaniem całości układu a ładowaniem baterii.
\newpage
\section{Ładowanie akumulatora LiFePO4}
\begin{figure}[!h]
	\centering
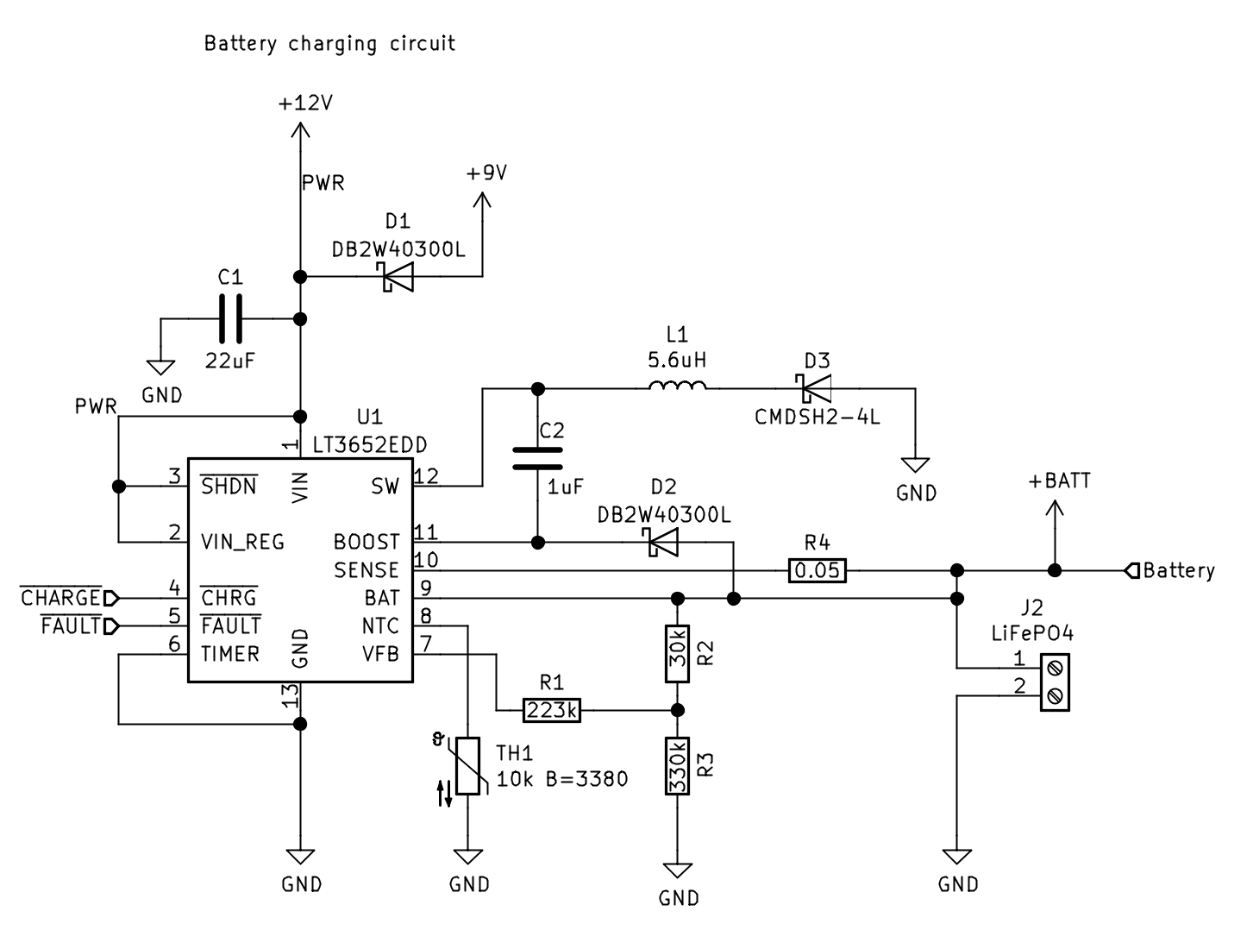
[picture p13: thesis/images/sch/sch-04.png]
	
	{\tytulyrozdzialow \footnotesize \caption[Schemat - ładowanie akumulatora] {Obrazek przedstawiający wycinek schematu z układem ładowania akumulatora LiFePO4}}
	\caption*{\textit{Źródło: Opracowanie własne}}
\end{figure}
\par Dioda typu Schottky D1 wykorzystana została jako rozdzielenie między ładowaniem akumulatora za pomocą zewnętrznego zasilacza a panelem słonecznym. Kondensator C10 o wartości 22µF posłużył jako odsprzęganie napięcia dla głównego układu ładującego, LT3652EDD firmy Linear Technology. Jest on specjalnie przystosowany do ładowania baterii wykonanych w różnych technologiach, typu akumulator kwasowy, Li-Ion czy LiFePO4 za pomocą ogniwa słonecznego prądem do 2A. Nie został wykorzystany pin TIMER do ustalania czasu ładowania akumulatora. 
\par Termistor TH1 posłużył do mierzenia temperatury ogniwa, przez co układ LT3652 mógł kontrolować cykle ładowania akumulatora. Rezystory R16, R14 i R17 posłużyły do ustalenia maksymalnego napięcia ogniwa; w ten sposób wybiera się rodzaj akumulatora podłączonego do kontrolera. Rezystor R12 wykorzystano do pomiaru prądu pobieranego przez baterię, co umożliwiło kontrolę cyklów ładowania akumulatora. Wyporwadzone zostały dwa sygnały, {$\sim$FAULT} i {$\sim$CHARGE} do mikrokontrolera ESP8266EX, dla indykacji statusu układu ładowania ogniwa.
\begin{table}[!h]
	\centering
	\resizebox{0.6\textwidth}{!}{%
		\begin{tabular}{|c|c|c|}
			\hline
			\rowcolor[HTML]{EFEFEF} 
			\multicolumn{2}{|c|}{\cellcolor[HTML]{EFEFEF}\textbf{Stan pinów}} & \cellcolor[HTML]{EFEFEF} \\ \cline{1-2}
			\rowcolor[HTML]{EFEFEF} 
			\textbf{$\sim$CHARGE} & \textbf{$\sim$FAULT} & \multirow{-2}{*}{\cellcolor[HTML]{EFEFEF}\textbf{Status kontrolera ładowania}} \\ \hline
			WYŁ. & WYŁ. & Nie ładuje — oczekiwanie lub wyłączanie. \\ \hline
			WYŁ. & WŁ. & Uszkodzona bateria \\ \hline
			WŁ. & WYŁ. & Ładowanie \\ \hline
			WŁ. & WŁ. & Błąd termistora \\ \hline
		\end{tabular}%
	}
	{\tytulyrozdzialow \footnotesize \caption[LT3652 - Sygnały statusu] {Tabela przedstawiająca sygnały wysyłane przez kontroler ładowania do mikrokontrolera.}}
	\caption*{\textit{Źródło: \cite{lt3652}}}
\end{table}
\section{Konwersja z 9V do 5.6V}
\begin{figure}[h]
	\centering
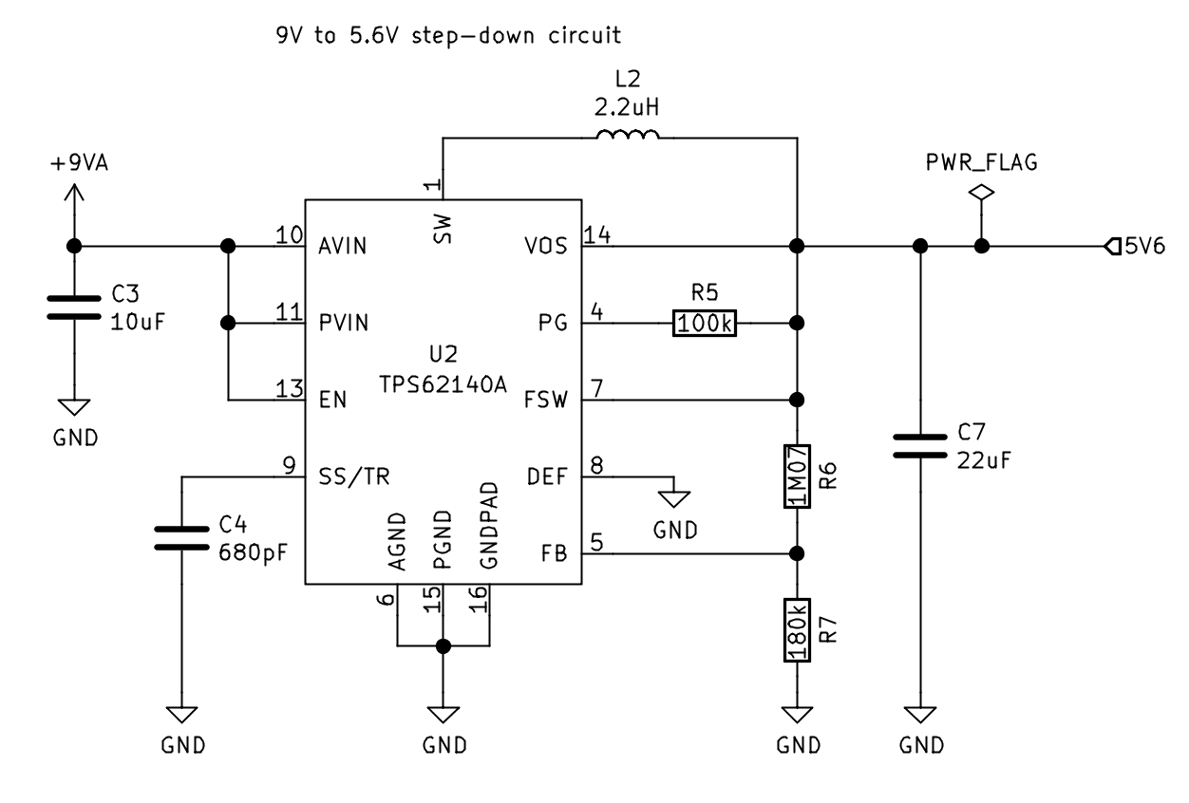
[picture p14: thesis/images/sch/sch-05.png]
	
	{\tytulyrozdzialow \footnotesize \caption[Schemat - konwersja do 5.6V] {Obrazek przedstawiający wycinek schematu z konwersją napięcia 9V do 5.6V dla zewnętrznego zasilania lub ładowania płytki głównej.}}
	\caption*{\textit{Źródło: Opracowanie własne}}
\end{figure}
\par Kondensator 10µF wykorzystano jako kondensator odsprzęgający dla układu konwertera DC-DC. Kolejny, o wartości 680pF posłużył do zapewnienia poprawnego działania przetwornicy, tak jak rezystor o wartości 100 kOhm podłączony do pinu PG (Power Good). Rezystory 1.07 MOhm oraz 180 kOhm ustawiły napięcie wyjściowe konwertera typu buck. Kondensator o wartości 22µF był niezbędny do prawidłowego obciążenia przetwornicy i filtracji wyjściowego napięcia. Cewka o wartości 2.2µH to element przechowujący energię dla układu do konwersji napięć.
\newpage
\section{Konektory dla sensorów pogodowych}
\begin{figure}[!h]
	\centering
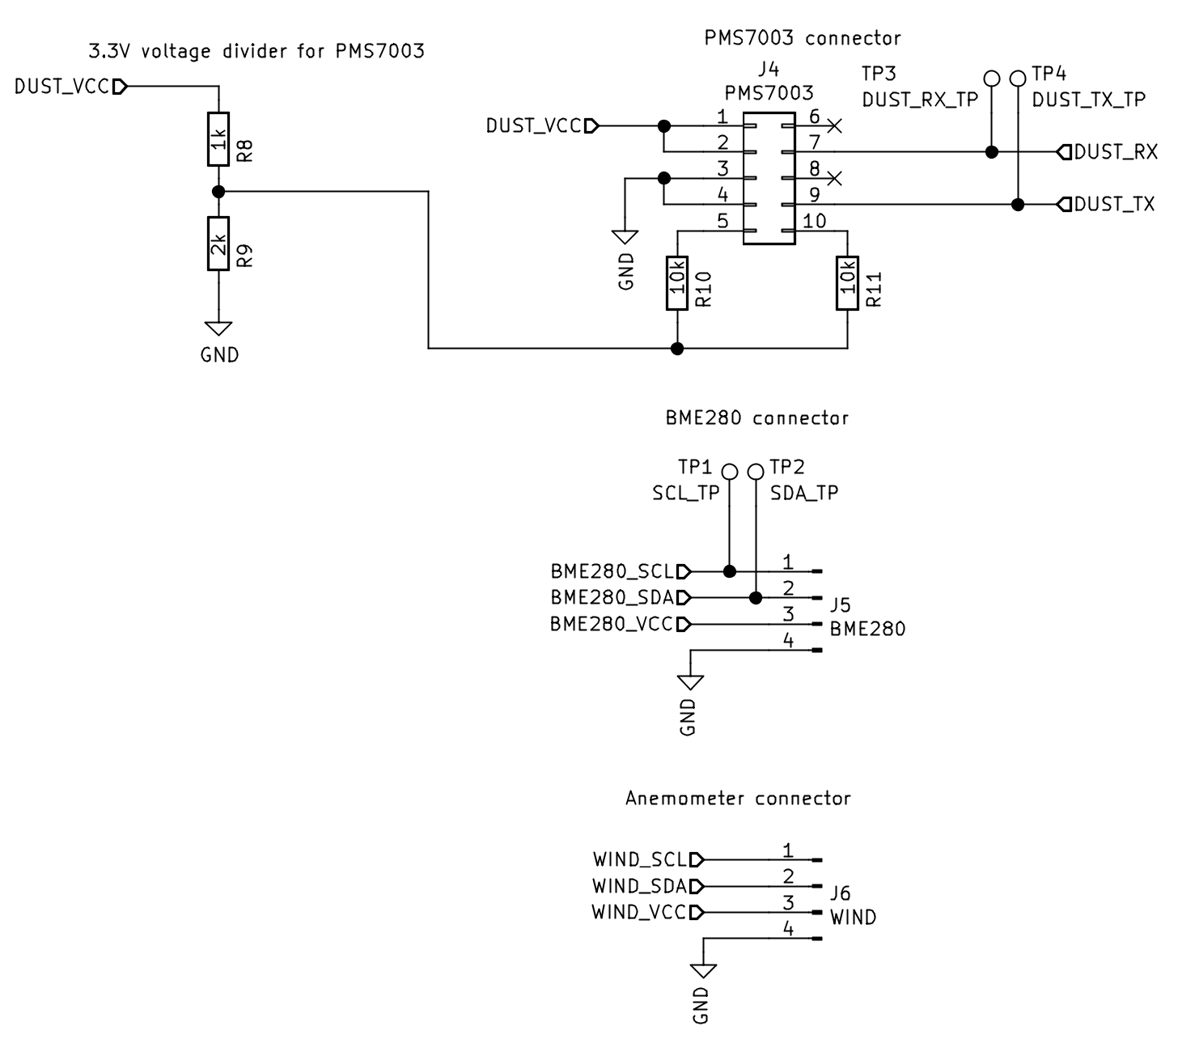
[picture p15: thesis/images/sch/sch-06.png]
	
	{\tytulyrozdzialow \footnotesize \caption[Schemat - konektory dla sensorów] {Obrazek przedstawiający wycinek schematu z konektorami dla sensorów.}}
	\caption*{\textit{Źródło: Opracowanie własne}}
\end{figure}
\par Przedstawiono tutaj połączenia między ESP8266EX a sensorami. Wykorzystano konektor 2-rzędowy, 5-kolumnowy dla PMS7003 oraz dwa 4 pinowe konektory 2.54mm. Dzielnik rezystorowy wykorzystano dla zmniejszenia napięcia zasilania PMS7003 z 5V do 3.3V, ponieważ komunikacja odbywa się na napięciu niższym niż napięcie zasilania czujnika.
Wykorzystano również rezystory podciągające o wartości 10kOhm dla linii SET i RESET, co zostało podane w nocie katalogowej tego sensora \cite{pms7003datasheet}.
\par Sensory wykorzystujące protokół I$^2$C nie wymagają tego typu zabiegów - zasilane są i komunikują się tym samym napięciem, wynoszącym 3.3V.
\par Dodano również punkty testowe dla obu protokołów dla obserwacji komunikacji między ESP8266EX a sensorami.
\newpage
\section{Wewnętrzny system dystrybucji zasilania}
\begin{figure}[!h]
	\centering
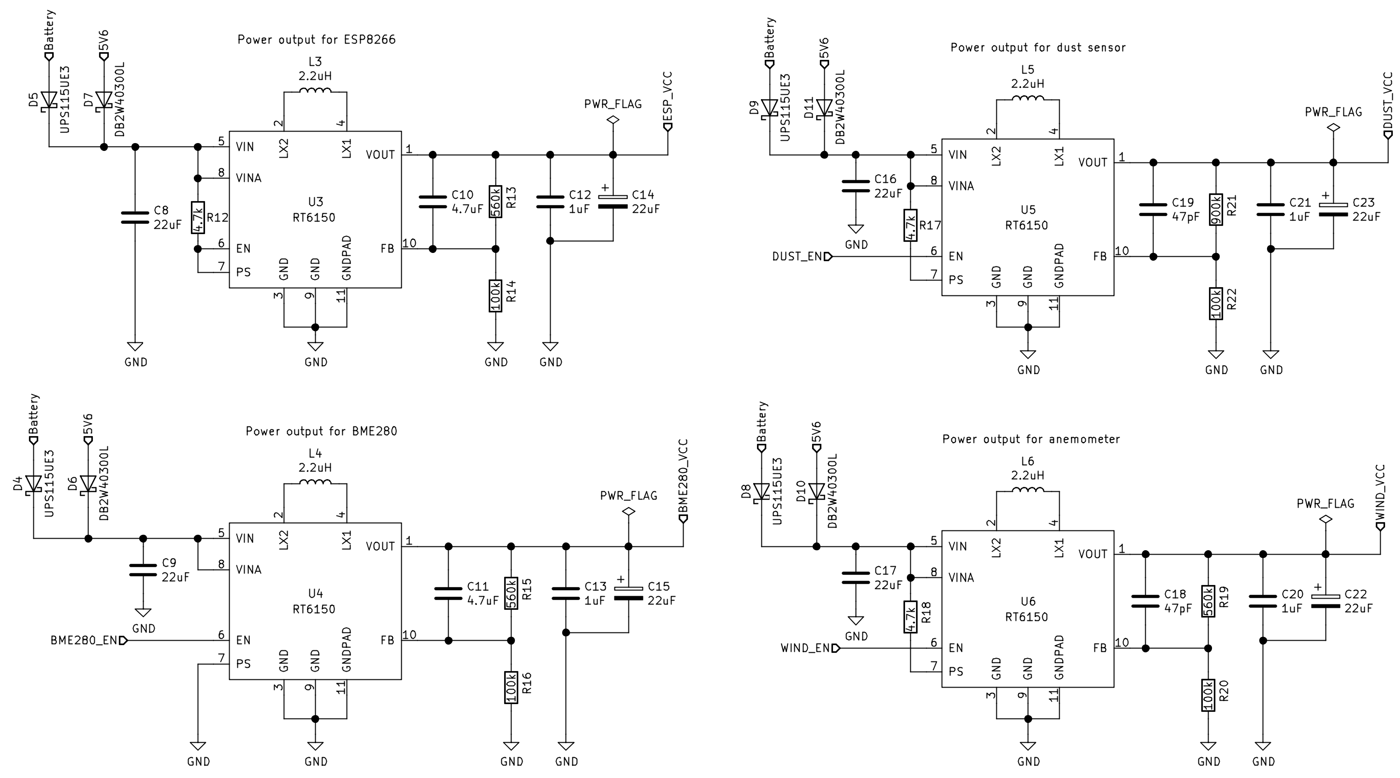
[picture p16: thesis/images/sch/sch-07.png]
	
	{\tytulyrozdzialow \footnotesize \caption[Schemat - układ dystrybucji zasilania] {Obrazek przedstawiający wycinek schematu z układem dystrybucji zasilania.}}
	\caption*{\textit{Źródło: Opracowanie własne}}
\end{figure}
\par Zastosowano 4 kanały zasilania - 3 kanały z napięciem wyjściowym 3.3V oraz 1 kanał z napięciem wyjściowym 5V. Linie 3.3V dostarczają napięcie dla ESP8266EX, anemometru oraz sensora BME280. Rozdzielono je dla zapewnienia maksymalnej stabilności napięc i prądów. Wykorzystano diody typu Schottky dla separacji linii wejściowych zasilania dla konwerterów DC-DC typu push-pull. Kondensatory o wartości 22µF działały jako odsprzęgające dla poprawnego działania przetwornic buck-boost. 
\par Wyprowadzono sygnały kontrolujące konwertery do mikroprocesora, oprócz jednego, który zasila ten mikrokontroler. Przetwornica dla BME280 jest wprowadzona w stan oszczędzania energii, ponieważ sensor BME280 pobiera bardzo małe ilości prądu. Zrobiono to dla podniesienia sprawności kontrolera. 
\par Wykorzystane networking to RT6150 firmy Richtek \cite{rt6150}. Ich maksymalne napięcie wejściowe wynosi 5.5V, a maksymalne napięcie wyjściowe - 5.5V. Maksymalny prąd wyjściowy wynosi 800 mA. Dzielnik rezystorowy na wyjściu przetwornicy jest potrzebny do ustalenia napięcia wyjściowego dla wykorzystywanych układów.
\newpage
\section{Pomiar napięcia baterii pinem ADC}
\begin{figure}[!h]
	\centering
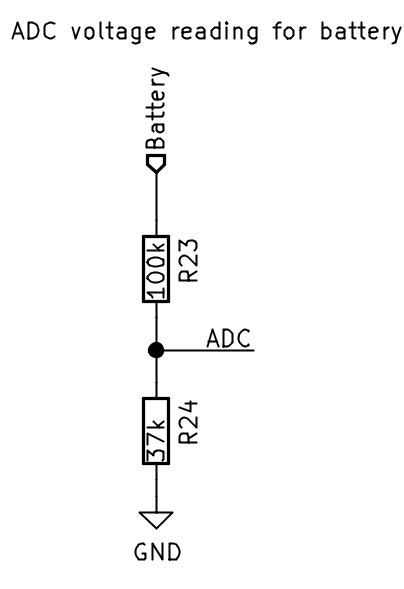
[picture p17: thesis/images/sch/sch-08.png]
	
	{\tytulyrozdzialow \footnotesize \caption[Schemat - sekcja ADC] {Obrazek przedstawiający wycinek schematu z pomiarem napięcia baterii przez ESP8266EX.}}
	\caption*{\textit{Źródło: Opracowanie własne}}
\end{figure}
\par Zastosowano prosty dzielnik rezystorowy do pomiaru napięcia baterii przez ESP8266EX. Maksymalne napięcie wejściowe pinu ADC w tym mikrokontrolerze to 1V \cite{esp8266datasheet}. Zastosowane wartości to 100 kOhm i 37 kOhm.
\section{Rezystory podciągające dla magistrali I$^2$C}
\begin{figure}[!h]
	\centering
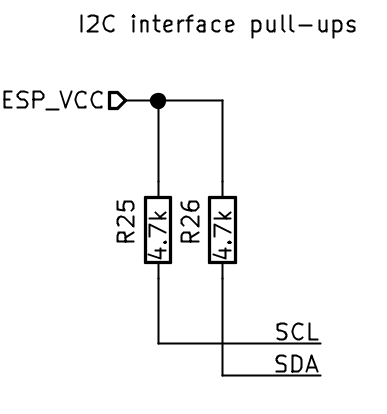
[picture p18: thesis/images/sch/sch-09.png]
	
	{\tytulyrozdzialow \footnotesize \caption[Schemat - rezystory interfejsu I$^2$C] {Obrazek przedstawiający wycinek schematu z rezystorami podciągającymi dla magistrali I$^2$C}}
	\caption*{\textit{Źródło: Opracowanie własne}}
\end{figure}
\par Zastosowano rezystory o wartości 2 kOhm jako podciągające do linii zasilania w celu zapewnienia maksymalnej możliwej prędkości transmisji danych w magistrali I$^2$C.
\newpage
\section{Pamięć Flash dla ESP8266EX}
\begin{figure}[!h]
	\centering
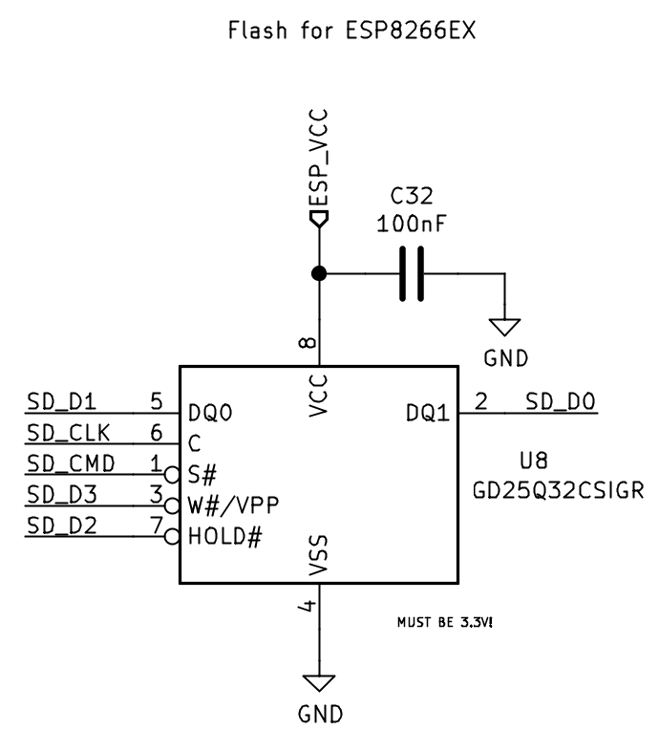
[picture p19: thesis/images/sch/sch-10.png]
	
	{\tytulyrozdzialow \footnotesize \caption[Schemat - pamięć flash] {Obrazek przedstawiający wycinek schematu z pamięcią flash dla ESP8266EX}}
	\caption*{\textit{Źródło: Opracowanie własne}}
\end{figure}
\par Podłączony został kondensator odsprzęgający o wartości 100nF dla zwiększenia stabilności jego działania. Komunikuje się po magistrali SPI z ESP8266EX. Wykorzystana pojemność to 32 MiB, czyli 4 MB. Umożliwia to napisanie rozbudowanego oprogramowania wewnętrznego do obsługi czujników oraz strony WWW.

\section{Linie wejść/wyjść ESP8266EX}
\begin{figure}[!h]
	\centering
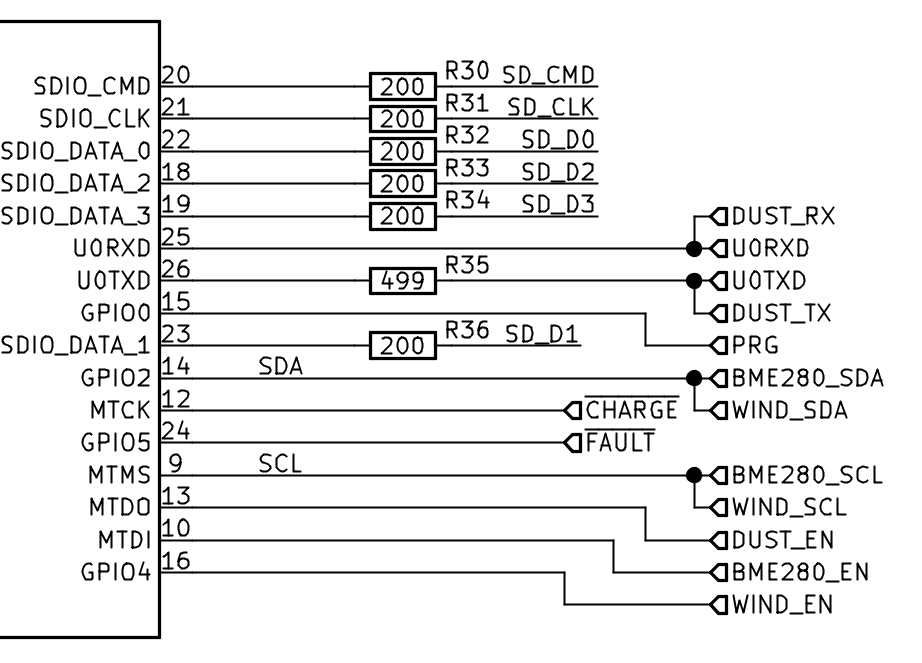
[picture p20: thesis/images/sch/sch-11.png]
	
	{\tytulyrozdzialow \footnotesize \caption[Schemat - komunikacja ESP8266EX z resztą płytki] {Obrazek przedstawiający wycinek schematu z komunikacją ESP8266EX z resztą płytki drukowanej.}}
	\caption*{\textit{Źródło: Opracowanie własne}}
\end{figure}
\par Wykorzystano trzy protokoły komunikacyjne - I$^2$C dla anemometru i BME280, UART dla PMS7003 oraz SPI dla pamięci flash. Zastosowano rezystory terminacyjne 200 ohm dla linii SPI, a 499 ohm dla UART - zgodnie z zaleceniami z Hardware Design Guidelines \cite{esp8266exhdg}. 
\par Pamięć flash komunikuje się z ESP8266EX w trybie QIO, najszybszym z możliwych. Dostępne są również inne tryby, takie jak QOUT,DIO oraz DOUT.
\par Wyprowadzono również pin PRG, który umożliwia wprowadzenie ESP8266EX w tryb programowania pamięci flash.
\par Sygnały {$\sim$CHARGE} i {$\sim$FAULT} pochodzą z kontrolera ładowania akumulatora LT3652EDD.
\newpage
\section{Sieć dopasowująca dla anteny Wi-Fi}
\begin{figure}[!h]
	\centering
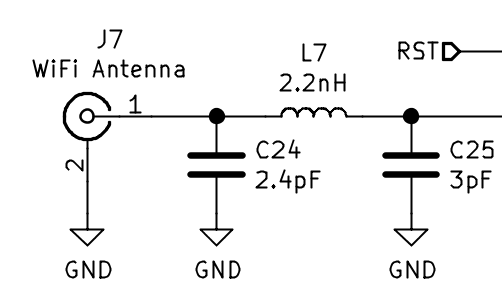
[picture p21: thesis/images/sch/sch-12.png]
	
	{\tytulyrozdzialow \footnotesize \caption[Schemat - sieć dopasowania dla anteny] {Obrazek przedstawiający wycinek schematu z siecią dopasowującą dla anteny Wi-Fi}}
	\caption*{\textit{Źródło: Opracowanie własne}}
\end{figure}
\par Wartości elementów wykorzystano z tzw. Hardware Design Guidelines dla ESP8266EX \cite{esp8266exhdg} dla dopasowania anteny Wi-Fi do wykorzystanego układu. Wykorzystano konektor SMA dla anteny Wi-Fi dla możliwośći podpięcia różnych anten, co daje więcej możliwości w zakresie regulacji zasięgu.
\section{Filtracja zasilania ESP8266EX}
\begin{figure}[!h]
	\centering
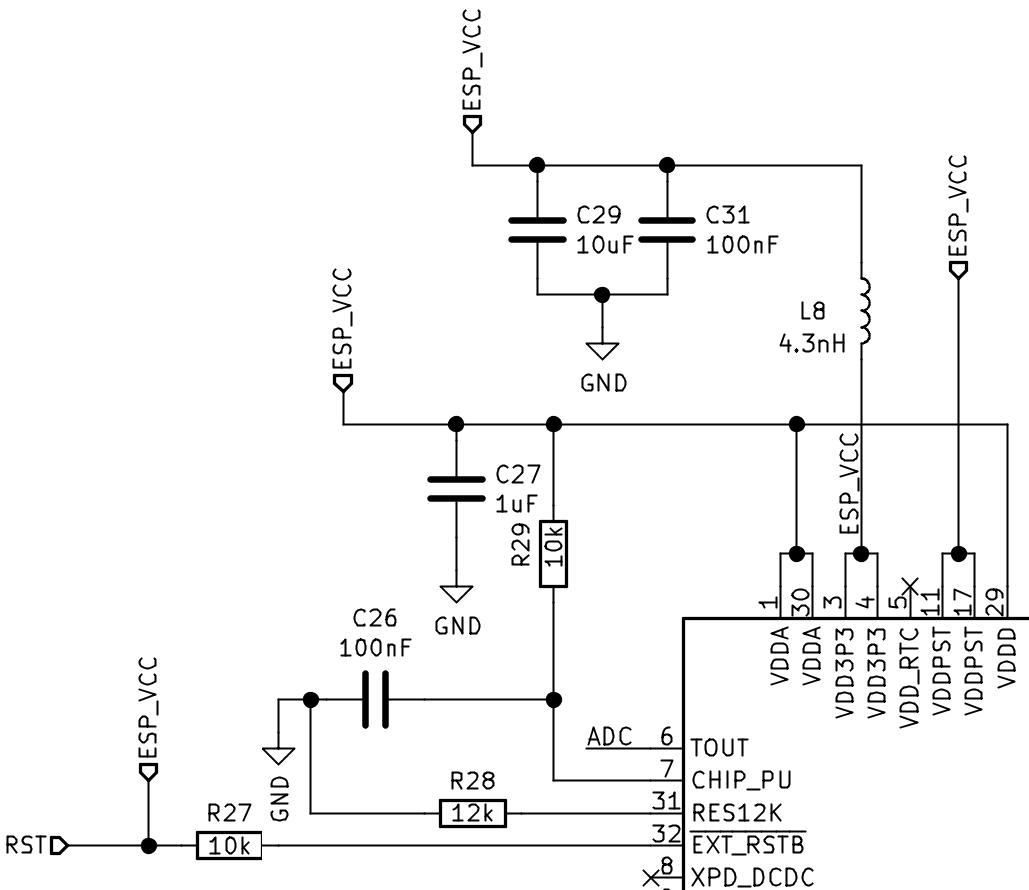
[picture p22: thesis/images/sch/sch-13.png]
	
	{\tytulyrozdzialow \footnotesize \caption[Schemat - filtracja zasilania ESP8266EX] {Obrazek przedstawiający wycinek schematu z filtracją zasilania dla ESP8266EX.}}
	\caption*{\textit{Źródło: Opracowanie własne}}
\end{figure}
\par ESP8266EX posiada 3 różne stopnie zasilania. VDD3P3 wymaga 2 kondensatorów i cewki,VDDA i VDDD jedynie kondensator, a VDDPST - nic. Rezystor podłączony do linii VDDA służy do utrzymania ESP8266EX w stanie działania - jest to rezystor podciągający.
\newpage
\section{Piny programowania ESP8266}
\begin{figure}[!h]
	\centering
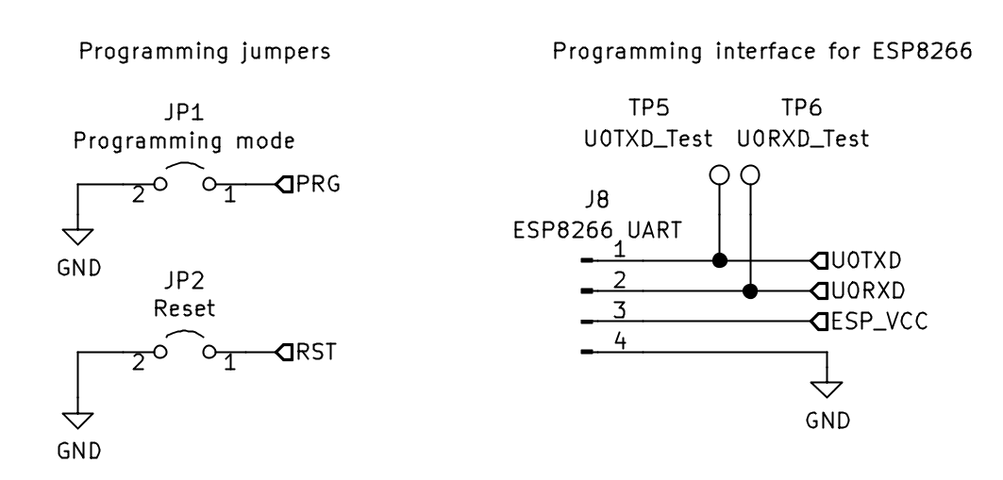
[picture p23: thesis/images/sch/sch-14.png]
	
	{\tytulyrozdzialow \footnotesize \caption[Schemat - programowanie wewnątrzukładowe] {Obrazek przedstawiający wycinek schematu z pinami dla programowania ESP8266EX}}
	\caption*{\textit{Źródło: Opracowanie własne}}
\end{figure}
\par Wykorzystano 2 zworki, jedna dla resetu ESP8266EX, druga dla przełączenia mikrokontrolera w tryb programowania.
\par Zastosowano 4 pinowy konektor dla programowania ESP8266EX za pomocą magistrali UART, wykorzystując napięcie 3.3V. 
\par Podpięto również 2 testowe pady dla inspekcji przebiegu programowania np. za pomocą analizatora stanów logicznych. 
\newpage
\chapter{Kod źródłowy} 
\section{Środowisko programistyczne}
\par Wykorzystano środowisko programistyczne o nazwie Eclipse IDE. Doinstalowano do niego wtyczkę Sloeber dla możliwości programowania za pomocą bibliotek Arduino.
\begin{figure}[!h]
	\centering
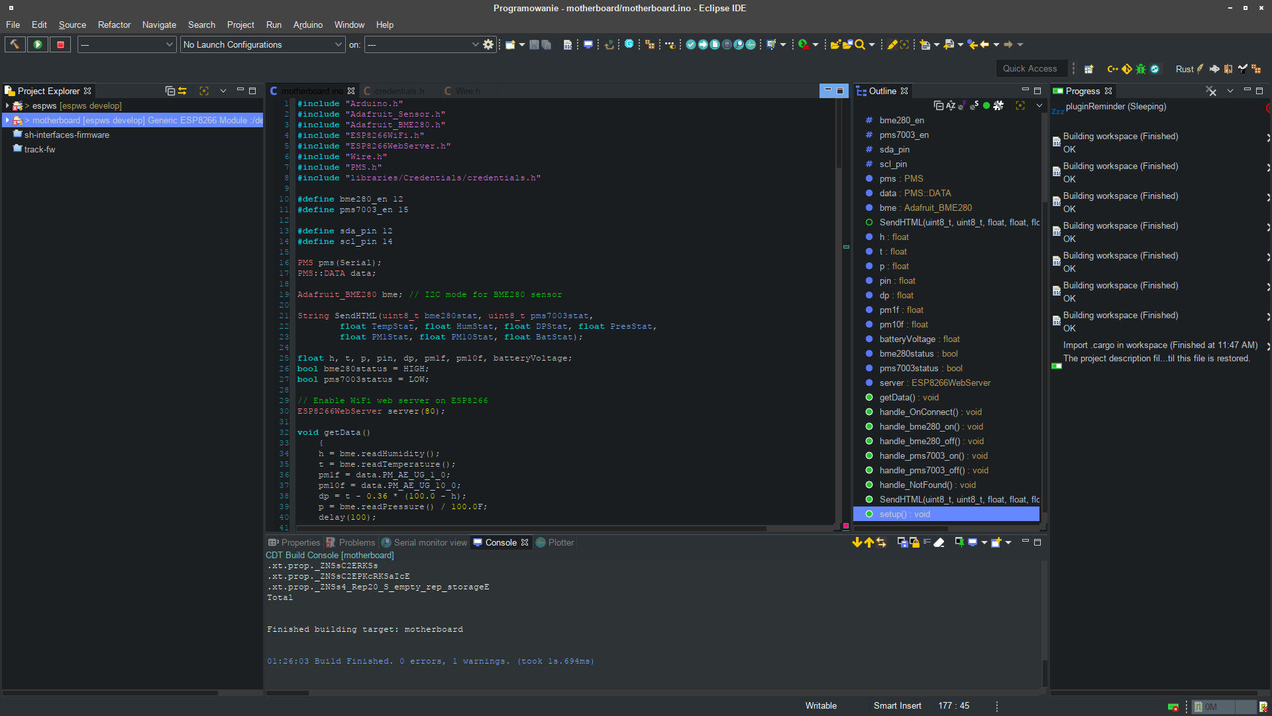
[picture p24: thesis/images/eclipse.png]
	
	{\tytulyrozdzialow \footnotesize \caption[IDE - Okno programu] {Obrazek przedstawiający okno programu Eclipse IDE, wykorzystanego do napisania programu.}}
	\caption*{\textit{Źródło: Opracowanie własne}}
\end{figure}
\par Eclipse IDE jest najpopularniejszym zintegrowanym środowiskiem programistycznym wśród programistów urządzeń wbudowanych czy też ,,Internetu Rzeczy''.
\section{Kod przez rozpoczęciem}
\begin{lstlisting}
#include "Arduino.h"
#include "Adafruit_Sensor.h"
#include "Adafruit_BME280.h"
#include "ESP8266WiFi.h"
#include "ESP8266WebServer.h"
#include "Wire.h"
#include "PMS.h"
#include "libraries/Credentials/credentials.h"

#define bme280_en 12
#define pms7003_en 15

#define sda_pin 12
#define scl_pin 14

PMS pms(Serial);
PMS::DATA data;

Adafruit_BME280 bme; // I2C mode for BME280 sensor

String SendHTML(uint8_t bme280stat, uint8_t pms7003stat,
float TempStat, float HumStat, float DPStat, float PresStat,
float PM1Stat, float PM10Stat, float BatStat);

float h, t, p, pin, dp, pm1f, pm10f, batteryVoltage;
bool bme280status = HIGH;
bool pms7003status = LOW;
\end{lstlisting}
\par Zainicjalizowano niezbędne biblioteki do obsługi wykorzystanych sensorów oraz plik nagłówkowy z wypisanym SSID sieci Wi-Fi oraz hasłem do niej.
\begin{lstlisting}
// Enable WiFi web server on ESP8266
ESP8266WebServer server(80);

void getData()
{
h = bme.readHumidity();
t = bme.readTemperature();
pm1f = data.PM_AE_UG_1_0;
pm10f = data.PM_AE_UG_10_0;
dp = t - 0.36 * (100.0 - h);
p = bme.readPressure() / 100.0F;
delay(100);
}
\end{lstlisting}
Serwer WWW zaczął działać, a w funkcji getData\(\) pobierane są pomiary z BME280 oraz PMS7003.
\begin{lstlisting}
void handle_OnConnect()
{
bme280status = HIGH;
pms7003status = LOW;
getData();
server.send(200, "text/html",
SendHTML(bme280status, pms7003status, t, h, dp, p, pm1f,
pm10f, batteryVoltage));
}
void handle_bme280_on()
{
bme280status = HIGH;
server.send(200, "text/html",
SendHTML(true, pms7003status, t, h, dp, p, pm1f, pm10f,
batteryVoltage));
}

void handle_bme280_off()
{
bme280status = LOW;
server.send(200, "text/html",
SendHTML(false, pms7003status, t, h, dp, p, pm1f, pm10f,
batteryVoltage));
}
void handle_pms7003_on()
{
pms7003status = HIGH;
server.send(200, "text/html",
SendHTML(bme280status, true, t, h, dp, p, pm1f, pm10f,
batteryVoltage));
}
void handle_pms7003_off()
{
pms7003status = LOW;
server.send(200, "text/html",
SendHTML(bme280status, false, t, h, dp, p, pm1f, pm10f,
batteryVoltage));
}
void handle_NotFound()
{
server.send(404, "text/plain", "Not found");
}
\end{lstlisting}
Występuje tutaj odświeżanie pomiarów oraz statusu pinów sterująćych przetwornicami przy każdym odświeżeniu strony przez zmianę statusu pinu sterującego zasilaniem innych sekcji płytki. Ustawiono również stany początkowe pinów.
\begin{lstlisting}
String SendHTML(uint8_t bme280stat, uint8_t pms7003stat,
float TempStat, float HumStat, float DPStat, float PresStat,
float PM1Stat, float PM10Stat, float BatStat)
{
String ptr = "<!DOCTYPE html> <html>\n";
ptr +=
"<head><meta name=\"viewport\" content=\"width=device-width, initial-scale=1.0, user-scalable=no\">\n";
ptr += "<meta charset='utf-8' />";
ptr += "<title>Stacja pogodowa </title>\n";
ptr += "</head>\n";
ptr += "<body>\n";
ptr += "<h1>Stacja pogodowa oparta o ESP8266</h1>\n";
ptr += "<h3>Tryb klienta.</h3>\n";
ptr += "<table border=\"2\" width=\"456\" cellpadding=\"10\"><tbody>";

ptr += "<tr><td>";
ptr += "</h3><h3>Temperatura = ";
ptr += "</td><td>";
ptr += TempStat;
ptr += "&deg;C</td></tr>";

ptr += "<tr><td>";
ptr += "</h3><h3>Wilgotność =";
ptr += "</td><td>";
ptr += HumStat;
ptr += "%</td></tr>";

ptr += "<tr><td>";
ptr += "</h3><h3>Punkt rosy = ";
ptr += "</td><td>";
ptr += DPStat;
ptr += "&deg;C</td></tr>";

ptr += "<tr><td>";
ptr += "</h3><h3>Ciśnienie = ";
ptr += "</td><td>";
ptr += PresStat;
ptr += "hPa ";
ptr += "</td></tr>";

ptr += "<tr><td>";
ptr += "</h3><h3>PM 1.0 (ug/m3) = ";
ptr += "</td><td>";
ptr += PM1Stat;
ptr += "</td></tr>";

ptr += "<tr><td>";
ptr += "</h3><h3>PM 10 (ug/m3) = ";
ptr += "</td><td>";
ptr += PM10Stat;
ptr += "</td></tr>";

ptr += "<tr><td>";

ptr += "</h3><h3>Napięcie baterii =";
ptr += "</td><td>";
ptr += BatStat;
ptr += "</td></tr>";
ptr += "</tbody></table>";

if (bme280stat)
{
ptr +=
"<p>Stan BME280: WYŁ</p><a class=\"button button-off\" href=\"/bme280_off\">WYŁ.</a>\n";
}
else
{
ptr +=
"<p>Stan BME280: WŁ</p><a class=\"button button-on\" href=\"/bme280_on\">WŁ.</a>\n";
}

if (pms7003stat)
{
ptr +=
"<p>Stan PMS7003 - WŁ.</p><a class=\"button button-off\" href=\"/pms7003_off\">WYŁ.</a>\n";
}
else
{
ptr +=
"<p>Stan PMS7003: WYŁ</p><a class=\"button button-on\" href=\"/pms7003_on\">WŁ.</a>\n";
}

ptr += "</body>\n";
ptr += "</html>\n";
return (ptr);
}
\end{lstlisting}
Znajduje się tutaj główne ciało strony wraz z polami, w których znajdują się wartości z pobranych sensorów oraz statusy pinów kontrolujących przetwornice.
\section{Kod rozpoczynający}
\begin{lstlisting}
void setup()
{
Serial.begin(9600); // GPIO1, GPIO3 (TX/RX pin for PMS7003
Serial1.begin(9600); // GPIO2; for debugging purposes.
Wire.begin(sda_pin, scl_pin);
Wire.setClock(100000); // Set I2C clock.
pinMode(bme280_en, OUTPUT); // Enable pin for BME280
pinMode(pms7003_en, OUTPUT); // Enable pin for PMS7003
Serial1.println();
Serial1.print("Lacze sie do: ");
Serial.println(mySSID);
WiFi.begin(mySSID, myPassword); // Start Wi-Fi transmission.

while (WiFi.status() != WL_CONNECTED)
{
delay(500);
Serial1.print(".");
}
Serial1.println();
Serial1.println("Wi-Fi podlaczone!!");
// Set multiple pages for toggling GPIOs

server.on("/", handle_OnConnect);
server.on("/bme280_on", handle_bme280_on);
server.on("/pms7003_on", handle_pms7003_on);
server.on("/bme280_off", handle_bme280_off);
server.on("/pms7003_off", handle_pms7003_off);
server.onNotFound(handle_NotFound);

// Start of web server
server.begin();
Serial1.println("Serwer WWW dziala - czekanie na IP dla ESP8266EX... ");
delay(5000);
// Printing ESP IP address
Serial1.println(WiFi.localIP());
Serial1.println(F("Test BME280"));

if (!bme.begin())
{
Serial1.println(
"Nie odnaleziono BME280, sprawdź połączenia sensor - płytka!");
while (1)
;
}
Serial1.println("BME280 dziala!");
}
\end{lstlisting}
\par Następuje tutaj ustawienie prędkości komunikacji ESP8266 z PMS7003, ustawienie pinów dla protokołu I$^2$C, zmiana trybu działania pinów kontrolujących przetwornice na wyjścia, zestawienie wielu odnośników dla odświeżania i zmiany statusu pinów oraz drugi port UART dla celów diagnostycznych.
\newpage
\section{Kod w pętli}
\begin{lstlisting}
void loop()
{
server.handleClient();
getData();
int analogValue = analogRead(A0) / 1000; // Setup analog pin
batteryVoltage = (analogValue * 137) / 37;
if (bme280status)
{
digitalWrite(bme280_en, HIGH);
}
else
{
digitalWrite(bme280_en, LOW);
}

if (pms7003status)
{
digitalWrite(pms7003_en, HIGH);
}
else
{
digitalWrite(pms7003_en, LOW);
}
}
\end{lstlisting}
\par Dokonano tutaj utrzymania połączeia z klientem, pobór danych analogowych jak i cyfrowych oraz logika zmiany stanu pinów kontrolujących przetwornice DC-DC.
\par Kod zajął około 260 linijek, przez co jest dość rozbudowanym programem.
\newpage
\chapter{Infografika} 
\section{Zdjęcia urządzenia}
\begin{figure} [!h]
	\centering
	
	{\tytulyrozdzialow \footnotesize \caption[Zdjęcie - układy scalone] {Zdjęcie przedstawiający płytkę z przylutowanymi układami scalonymi}}
	\caption*{\textit{Źródło: Opracowanie własne}}
\end{figure}
\begin{figure} [!h]
	\centering
	
	{\tytulyrozdzialow \footnotesize \caption[Zdjęcie - ukończona płytka] {Zdjęcie przedstawiający płytkę z przylutowanymi wszystkimi elementami. Do tego odwrotnie przylutowany kondensator, który naprawiono.}}
	\caption*{\textit{Źródło: Opracowanie własne}}
\end{figure}
\begin{figure} [!h]
	\centering
	
	{\tytulyrozdzialow \footnotesize \caption[Zdjęcie - wnętrze projektu] {Zdjęcie przedstawiający wnętrze projektu z przykręconym akumulatorem}}
	\caption*{\textit{Źródło: Opracowanie własne}}
\end{figure}
\begin{figure} [!h]
	\centering
	
	{\tytulyrozdzialow \footnotesize \caption[Zdjęcie - wygląd projektu] {Zdjęcie przedstawiający część zewnętrzną projektu, złożoną i gotową do pracy.}}
	\caption*{\textit{Źródło: Opracowanie własne}}
\end{figure}
\section{Pomiar sekcji zasilania ESP8266EX}
\begin{figure} [!h]
	\centering
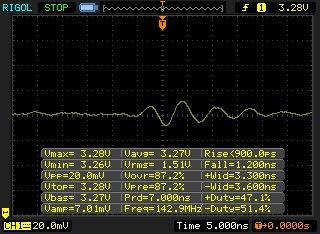
[picture p25: thesis/images/photos/5.jpg]
	
	{\tytulyrozdzialow \footnotesize \caption[Pomiar - zasilanie ESP8266] {Zdjęcie przedstawiające pomiar linii zasilania ESP8266}}
	\caption*{\textit{Źródło: Opracowanie własne}}
\end{figure}
\par Wykorzystana przetwornica DC-DC RT6150 dała znakomite rezultaty jeśli chodzi o zasilanie projektu. Pomiar szumu pokazał, że jest on marginalny i nie wpływa na działanie całości. Zasilanie za pomocą tychże układów dało stabilne rezultaty.
\begin{figure} [!h]
	\centering
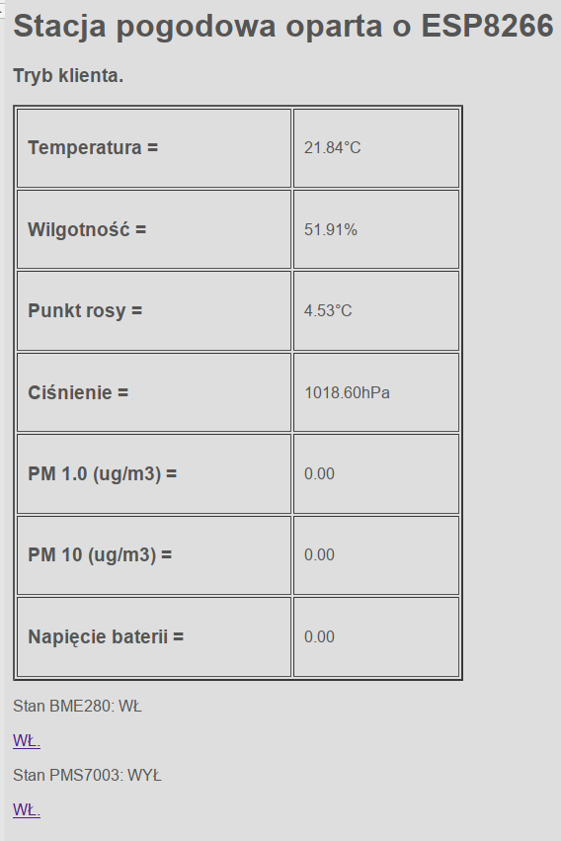
[picture p26: thesis/images/app01.png]
	
	{\tytulyrozdzialow \footnotesize \caption[Aplikacja - strona główna] {Zdjęcie przedstawiające stronę główną aplikacji.}}
	\caption*{\textit{Źródło: Opracowanie własne}}
\end{figure}
\newpage
\chapter{Streszczenie} 
\par Wykorzystano do projektu mikrokontroler ESP8266EX, czujnik cząsteczek stałych PMS7003 oraz sensor temperatury, wilgoci oraz ciśnienia BME280. Wyprowadzono również konektor dla czujnika prędkości i kierunku wiatru dla przyszłej rozbudowy.BME280 wykorzystuje protokół I$^2$C, a PMS7003 - UART. Anemometr powinien być zasilany napięciem 3.3V oraz wykorzystywać protokół I$^2$C do komunikacji z mikroprocesorem.
\par Zaprojektowana i wykonana została płytka drukowana (PCB). Zaprojektowana została za pomocą KiCAD \cite{kicad}, a wykonana przez firmę JLCPCB - \url{jlcpcb.com} w cenie 200 PLN, licząc przesyłkę firmą kurierską UPS. Elementy zamówiono na stronie DigiKey - \url{digikey.pl}, które przyszły z USA firmą kurierską UPS.
\par Oprogramowanie zawiera obsługę czujnika PMS7003, BME280 oraz kontrolę przetwornicami DC-DC RT6150 firmy Richtek dla lepszego zarządzania energią całego układu.
Wykorzystano również pin analogowy ESP8266EX dla pomiaru stanu baterii przez dzielnik rezystorowy.
\par Układ może być zasilany na 2 sposoby - z zewnętrznego zasilacza o napięciu 9V i prądzie 3A oraz za pomocą baterii LiFePO4 o napięciu nominalnym 3.2V. Akumulator można ładować panelem słonecznym o napięciu 12V podczas obciążenia oraz zewnętrznym, 9V 3A zasilaczem. Istnieje możliwość wyboru, czy zewnętrzny zasilacz ma ładować akumulator, czy zasilać cały układ.
\par Do programowania ESP8266EX wykorzystywany jest protokół UART oraz napięcie zasilania o wartości 3.3V.
Domyślna prędkość komunikacji ESP8266EX ze ,,światem'' wynosi 74880 bodów dla rezonatora kwarcowego 26 MHz. Dla 40 MHz rezonatora ta prędkość wynosi 115200 bodów.
\par ESP8266EX obsługuje łączność Wi-Fi w trybach b/g/n - jako punkt dostępu, klient oraz tryb podsłuchu.
\par ESP8266EX nie posiada wbudowanej pamięci flash dla przechowywania programów - niezbędna jest zewnętrzna pamięć. Jego odmiana, ESP8285 - posiada wbudowane 1 MiB pamięci typu flash.
\par Wykorzystano zintegrowane środowisko programistyczne Eclipse IDE oraz biblioteki Arduino.
\newpage
\listoffigures
\newpage
\listoftables
\newpage
\begin{thebibliography}{16}
	\bibitem{esp8266wiki}
	,,ESP8266'',
	\textit{Wikipedia},
	Zebrane 3 marca 2019,
	\url{https://en.wikipedia.org/wiki/ESP8266}
	\bibitem{esp8266datasheet}
	Nota katalogowa ESP8266,
	\textit{Espressif},
	Zebrane 25 lutego 2019,
	\url{https://www.espressif.com/sites/default/files/documentation/0a-esp8266ex_datasheet_en.pdf}
	\bibitem{esp8266chip}
	Zdjęcie ESP8266EX,
	\textit{alphamicrowireless.com}
	Zebrane 3 marca 2019,
	\url{http://www.alphamicrowireless.com/media/562039/esp8266ex_370px.gif}
	\bibitem{esp8266pinout}
	Pinout ESP8266EX,
	\textit{acrobotic.com},
	Zebrane 3 marca 2019,
	\url{https://learn.acrobotic.com/uploads/esp8266_pinout.png}
	\bibitem{bme280datasheet}
	Nota katalogowa BME280,
	\textit{Bosch},
	Zebrane 25 lutego 2019,
	\url{https://ae-bst.resource.bosch.com/media/_tech/media/datasheets/BST-BME280-DS002.pdf}
	\bibitem{bme280chip}
	Zdjęcie przedstawiające układ BME280,
	\textit{dnatechindia.com}
	Zebrane 3 marca 2019,
	\url{http://www.dnatechindia.com/image/cache/catalog/bme280\%201-500x500.jpg}
	\bibitem{bme280module}
	Zdjęcie przedstawiające gotowy moduł z układem BME280,
	\textit{gunook.com}
	Zebrane 3 marca 2019,
	\url{http://img.gunook.com/upload/a/1d/a1d0568812635b491d33f680db52a587.jpg}
	\bibitem{pms7003datasheet}
	Przetłumaczona nota katalogowa PMS7003,
	\textit{github.com}
	Zebrane 26 lutego 2019,
	\url{https://raw.githubusercontent.com/eleparts/PMS7003/master/data\%20sheet/PMS7003\%20datasheet.pdf}
	\bibitem{pms7003module}
	Zdjęcie sensora PMS7003,
	\textit{amazon.com}
	Zebrane 3 marca 2019,
	\url{https://images-na.ssl-images-amazon.com/images/I/41KI\%2BnbtAGL._SX342_.jpg}
	\bibitem{i2cwiki}
	,,I$^2$C'',
	\textit{Wikipedia}
	Zebrane 3 marca 2019,
	\url{https://en.wikipedia.org/wiki/I%C2%B2C}
	\bibitem{uartwiki}
	,,Universal asynchronous receiver-transmitter'', 
	\textit{Wikipedia}
	Zebrane 3 marca 2019,
	\url{https://en.wikipedia.org/wiki/Universal_asynchronous_receiver-transmitter}	
	\bibitem{kicad}
	\textit{KiCAD EDA},
	Zebrane 3 marca 2019,
	\url{http://kicad-pcb.org/}
	\bibitem{lt3652}
	Nota katalogowa LT3652,
	\textit{Linear Technology},
	Zebrane 3 marca 2019,
	\url{https://www.analog.com/media/en/technical-documentation/data-sheets/3652fe.pdf}
	\bibitem{rt6150}
	Nota katalogowa RT6150,
	\textit{Richtek}
	Zebrane 3 marca 2019,
	\url{https://www.richtek.com/assets/product_file/RT6150A=RT6150B/DS6150AB-05.pdf}
	\bibitem{esp8266exhdg}
	Zalecenia dla projektowania dla ESP8266EX,
	\textit{Espressif}
	Zebrane 3 marca 2019,
	\url{https://www.espressif.com/sites/default/files/documentation/esp8266_hardware_design_guidelines_en.pdf}
\end{thebibliography}
\end{document}
