KhazAkar/espws/presentation/PL/presentation.pdf

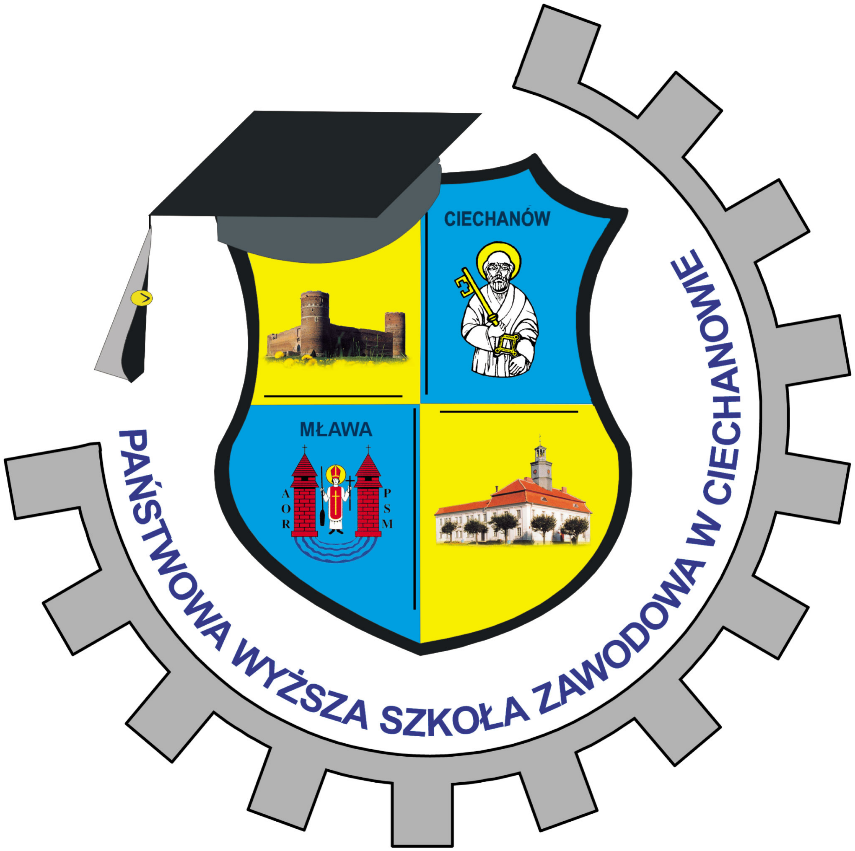
[picture p46: figure]

## Stacja meteorologiczna oparta o ESP8266

Damian Zaręba

Promotor: dr inż. Tadeusz Leszczyński

Recenzent: dr inż. Mariusz Tupaj

Państwowa Wyższa Szkoła Zawodowa w Ciechanowie, Zamiejscowy Wydział Elektroniki, Dziennikarstwa i Technik Multimedialnych w Mławie

Damian Zaręba (PWSZ Ciechanów) | Stacja meteorologiczna oparta o ESP8266 | 1 / 10

## Cel pracy

Pierwszym celem pracy jest zaprojektowanie i zrealizowanie stacji meteorologicznej opartej o mikroprocesor ESP8266, złożonej z kilku modułów:
Płyta główna z zasilaniem i mikroprocesorem;
Modułem sensora BME280, do pomiaru ciśnienia, temperatury i wilgotności;
Modułem czujnika PMS7003, do pomiaru zanieczyszczeń powietrza. Drugim celem pracy jest nauka projektowania płytek drukowanych o wyższym stopniu skomplikowania niż dotychczas.
Damian Zaręba (PWSZ Ciechanów) | Stacja meteorologiczna oparta o ESP8266 | 2 / 10

## Wykorzystane elementy

Wykorzystano kilka głównych układów do zrealizowania tego projektu: ESP8266EX dla przetwarzania i komunikacji;
BME280 dla pomiarów ciśnienia, temperatury i wilgotności; PMS7003 do pomiarów zanieczyszczeń;
LT3652 dla kontroli ładowania baterii LiFePO4 za pomocą panelu słonecznego i zewnętrznej ładowarki 9V;
RT6150 do dystrybucji i kontroli napięcia z akumulatora, daje wyjściowe napięcia 3.3V i 5V;
TPS62140A dla zmniejszenia napięcia wejściowego ładowarki z 9V do 5.6V, żeby móc zasilać nią cały system.
Damian Zaręba (PWSZ Ciechanów) | Stacja meteorologiczna oparta o ESP8266 | 3 / 10

## Schemat

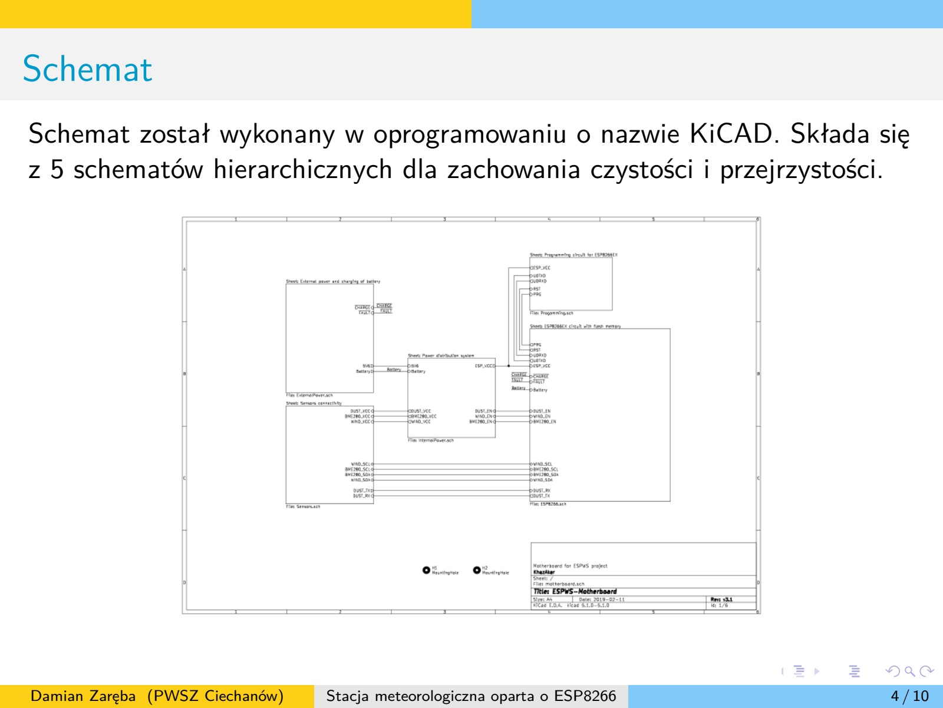
[picture p47: page 4]

Schemat został wykonany w oprogramowaniu o nazwie KiCAD. Składa się z 5 schematów hierarchicznych dla zachowania czystości i przejrzystości.

Damian Zaręba (PWSZ Ciechanów) | Stacja meteorologiczna oparta o ESP8266 | 4 / 10

## PCB

Zaprojektowano płytkę drukowaną z wykorzystaniem 4 warstw, w następującej konfiguracji: Sygnał - Masa - Zasilanie - Sygnał


Damian Zaręba (PWSZ Ciechanów) | Stacja meteorologiczna oparta o ESP8266 | 5 / 10

## Kod źródłowy

Kod źródłowy projektu został napisany z wykorzystaniem Eclipse IDE i pluginu Sloeber. Wykorzystano biblioteki Arduino z uwagi na prostotę implementacji i duże możliwości dostępnych, dodatkowych bibliotek.


Damian Zaręba (PWSZ Ciechanów) | Stacja meteorologiczna oparta o ESP8266 | 6 / 10

## Działanie projektu

Menu całości jest proste i przejrzyste - pozwala na podgląd pomiarów oraz parametrów, jak i na kontrolę pinów kontrolujących przetwornice DC-DC. Dostępny jest podgląd temperatury, ciśnienia, wilgotności, zanieczyszczeń PM1 oraz PM10. Z parametrów dostępny jest pomiar napięcia na baterii. Umożliono także kontrolę nad zasilaniem czujników.

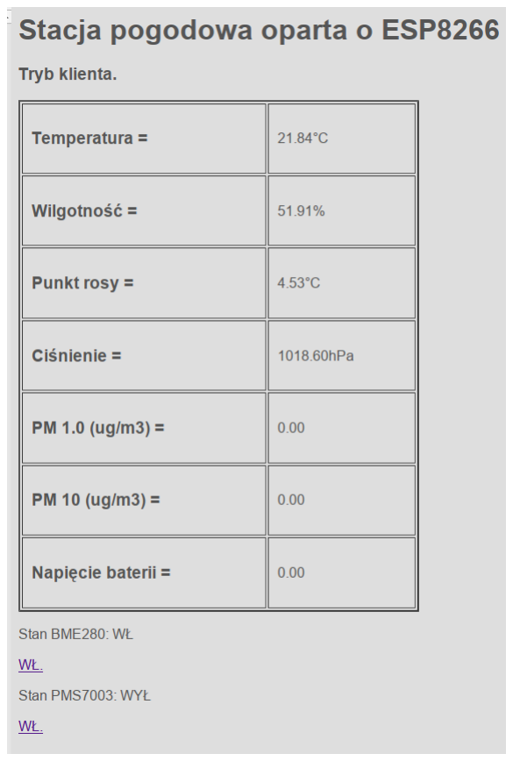
[picture p48: figure]

Damian Zaręba (PWSZ Ciechanów) | Stacja meteorologiczna oparta o ESP8266 | 7 / 10

## Napotkane problemy

Wystąpiło kilka problemów:
Do zaprogramowania układu potrzeba przylutować kilka dodatkowych przewodów; wyporwadzone pierwotnie piny są niewystarczające Sygnały ∼CHARGE i ∼FAULT nie mogą być wykorzystane - brak rezystorów podciągających
Dużą ilość przelotek na ścieżce wejściowej z panelu słonecznego -dodają niepotrzebną rezystancję w tej konfiguracji
Damian Zaręba (PWSZ Ciechanów) | Stacja meteorologiczna oparta o ESP8266 | 8 / 10

## Możliwe rozwiązania problemów

Każdy z tych problemów da się rozwiązać jedynie przez modyfikację schematu i płytki drukowanej, a mianowicie:
Wyprowadzenie wszystkich niezbędnych sygnałów programowania; Dodanie rezystorów podciągających do sygnałów ∼CHARGE i ∼FAULT;
Usunięcie przelotek z ścieżki i poszerzenie jej tak, żeby mogła spełniać założenia.
Damian Zaręba (PWSZ Ciechanów) | Stacja meteorologiczna oparta o ESP8266 | 9 / 10

## Przyszłość projektu

Projekt będzie cały czas rozwijany w wolnym czasie. Będą tworzone nowe rewizje schematu oraz płytek drukowanych dla lepszego przystosowania projektu do sprzedaży gotowych produktów z jego wykorzystaniem.

Damian Zaręba (PWSZ Ciechanów) | Stacja meteorologiczna oparta o ESP8266 | 10 / 10
