KhazAkar/espws/concepts/Diagram.png

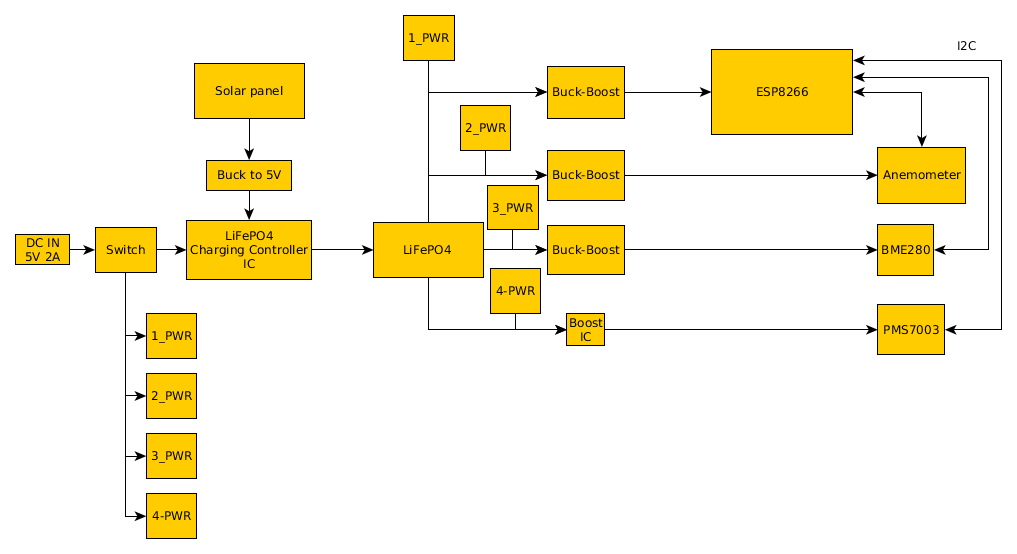
concepts/Diagram.png
