KhazAkar/espws/hw/motherboard/BOM-DIgiKey.xlsx

# | Quantity | Part Number | Manufacturer Part Number | Description | Customer Reference | Backorder | Unit Price | Extended Price
1 | 5 | 1904-1001-1-ND | ESP8266EX | IC RF TXRX+MCU WIFI 32VFQFN |  | 0 | 602000 | 30,10 zł
2 | 3 | WM5534-ND | 0732511150 | CONN SMA RCPT STR 50OHM EDGE MNT |  | 0 | 1312000 | 39,36 zł
3 | 3 | 1970-1025-1-ND | GD25Q32CSIGR | NOR FLASH |  | 0 | 308000 | 9,24 zł
4 | 15 | PCE3952CT-ND | EEE-1VA220SP | CAP ALUM 22UF 20% 35V SMD |  | 0 | 94800 | 14,22 zł
5 | 12 | 399-1100-1-ND | C0603C104Z3VACTU | CAP CER 0.1UF 25V Y5V 0603 |  | 0 | 13500 | 1,62 zł
6 | 6 | 587-4867-1-ND | EMK107BC6106MA-T | CAP CER 10UF 16V X6S 0603 |  | 0 | 196000 | 11,76 zł
7 | 3 | 1276-1080-1-ND | CL10B681KB8NNNC | CAP CER 680PF 50V X7R 0603 |  | 0 | 38000 | 1,14 zł
8 | 15 | 1276-6751-1-ND | CL10A226MPMNUBE | CAP CER 22UF 10V X5R 0603 |  | 0 | 99600 | 14,94 zł
9 | 18 | 1276-1182-1-ND | CL10A105KP8NNNC | CAP CER 1UF 10V X5R 0603 |  | 0 | 14300 | 2,57 zł
10 | 3 | 1284-1201-1-ND | 600S2R4BT250XT | CAP CER 2.4PF 250V C0G/NP0 0603 |  | 0 | 342000 | 10,26 zł
11 | 3 | 1284-1213-1-ND | 600S3R0BT250XT | CAP CER 3PF 250V C0G/NP0 0603 |  | 0 | 350000 | 10,50 zł
12 | 10 | 311-1058-1-ND | CC0603JRNPO9BN100 | CAP CER 10PF 50V C0G/NPO 0603 |  | 0 | 22900 | 2,29 zł
13 | 6 | 1276-1044-1-ND | CL10A475KP8NNNC | CAP CER 4.7UF 10V X5R 0603 |  | 0 | 56000 | 3,36 zł
14 | 6 | 478-1171-1-ND | 06035A470JAT2A | CAP CER 47PF 50V C0G/NP0 0603 |  | 0 | 38000 | 2,28 zł
15 | 18 | DB2W40300LCT-ND | DB2W40300L | DIODE SCHOTTKY 40V 3A MINI2 |  | 0 | 158300 | 28,49 zł
16 | 3 | CMDSH2-4LCT-ND | CMDSH2-4L TR | DIODE SCHOTTKY 40V 200MA SOD323 |  | 0 | 196000 | 5,88 zł
17 | 12 | UPS115UE3/TR7CT-ND | UPS115UE3/TR7 | DIODE SCHOTTKY 15V 1A POWERMITE |  | 0 | 327500 | 39,30 zł
18 | 6 | 277-1667-ND | 1935161 | TERM BLK 2POS SIDE ENTRY 5MM PCB |  | 0 | 162000 | 9,72 zł
19 | 3 | CP-063AH-ND | PJ-063AH | CONN PWR JACK 2X5.5MM SOLDER |  | 0 | 511000 | 15,33 zł
20 | 3 | 609-3712-ND | 20021111-00010T4LF | CONN HEADER VERT 10POS 1.27MM |  | 0 | 252000 | 7,56 zł
21 | 3 | S7002-ND | PPTC041LFBN-RC | CONN HDR 4POS 0.1 TIN PCB |  | 0 | 169000 | 5,07 zł
22 | 15 | 732-1095-1-ND | 7440430022 | FIXED IND 2.2UH 2.5A 28 MOHM SMD |  | 0 | 522300 | 78,35 zł
23 | 3 | SRP6540-5R6MCT-ND | SRP6540-5R6M | FIXED IND 5.6UH 5.5A 38 MOHM SMD |  | 0 | 560000 | 16,80 zł
24 | 3 | 490-1161-1-ND | LQW18AN4N3D00D | FIXED IND 4.3NH 850MA 59 MOHM |  | 0 | 64000 | 1,92 zł
25 | 3 | 490-6794-1-ND | LQW15AN2N2C10D | FIXED IND 2.2NH 1A 27 MOHM SMD |  | 0 | 79000 | 2,37 zł
26 | 18 | 311-100KHRCT-ND | RC0603FR-07100KL | RES SMD 100K OHM 1% 1/10W 0603 |  | 0 | 9000 | 1,62 zł
27 | 3 | YAG3333CT-ND | RC0805FR-071M07L | RES SMD 1.07M OHM 1% 1/8W 0805 |  | 0 | 38000 | 1,14 zł
28 | 10 | CR0603-FX-1803ELFCT-ND | CR0603-FX-1803ELF | RES SMD 180K OHM 1% 1/10W 0603 |  | 0 | 21100 | 2,11 zł
29 | 12 | 311-10.0KHRCT-ND | RC0603FR-0710KL | RES SMD 10K OHM 1% 1/10W 0603 |  | 0 | 9000 | 1,08 zł
30 | 18 | 311-200HRCT-ND | RC0603FR-07200RL | RES SMD 200 OHM 1% 1/10W 0603 |  | 0 | 9000 | 1,62 zł
31 | 10 | 311-12.0KHRCT-ND | RC0603FR-0712KL | RES SMD 12K OHM 1% 1/10W 0603 |  | 0 | 9000 | 0,90 zł
32 | 3 | FCSL150R050FERCT-ND | FCSL150R050FER | RES 0.05 OHM 10W 2959 WIDE |  | 0 | 2395000 | 71,85 zł
33 | 10 | CR0603-FX-4990ELFCT-ND | CR0603-FX-4990ELF | RES SMD 499 OHM 1% 1/10W 0603 |  | 0 | 7900 | 0,79 zł
34 | 10 | 311-30KGRCT-ND | RC0603JR-0730KL | RES SMD 30K OHM 5% 1/10W 0603 |  | 0 | 7500 | 0,75 zł
35 | 10 | 311-221KHRCT-ND | RC0603FR-07221KL | RES SMD 221K OHM 1% 1/10W 0603 |  | 0 | 9000 | 0,90 zł
36 | 10 | 311-330KGRCT-ND | RC0603JR-07330KL | RES SMD 330K OHM 5% 1/10W 0603 |  | 0 | 7500 | 0,75 zł
37 | 10 | 311-2.00KHRCT-ND | RC0603FR-072KL | RES SMD 2K OHM 1% 1/10W 0603 |  | 0 | 9000 | 0,90 zł
38 | 10 | 311-39.0KHRCT-ND | RC0603FR-0739KL | RES SMD 39K OHM 1% 1/10W 0603 |  | 0 | 9000 | 0,90 zł
39 | 10 | 311-150KHRCT-ND | RC0603FR-07150KL | RES SMD 150K OHM 1% 1/10W 0603 |  | 0 | 9000 | 0,90 zł
40 | 10 | 311-4.70KHRCT-ND | RC0603FR-074K7L | RES SMD 4.7K OHM 1% 1/10W 0603 |  | 0 | 9000 | 0,90 zł
41 | 10 | 311-1.0KGRCT-ND | RC0603JR-071KL | RES SMD 1K OHM 5% 1/10W 0603 |  | 0 | 7500 | 0,75 zł
42 | 3 | EG2447-ND | 200MSP1T1B1M2QEH | SWITCH TOGGLE SPDT 3A 120V |  | 0 | 838000 | 25,14 zł
43 | 3 | 490-7167-ND | NXRT15XH103FA1B040 | THERMISTOR NTC 10KOHM 3380K BEAD |  | 0 | 263000 | 7,89 zł
44 | 3 | 296-41756-1-ND | TPS62140ARGTR | IC REG BUCK ADJ 2A SYNC 16QFN |  | 0 | 782000 | 23,46 zł
45 | 3 | LT3652EDD#PBF-ND | LT3652EDD#PBF | IC BATTERY CHARGER 12-DFN |  | 0 | 2594000 | 77,82 zł
46 | 12 | 1028-1259-1-ND | RT6150AGQW | IC REG BUCK BST ADJ 0.8A 10WDFN |  | 0 | 552700 | 66,32 zł
47 | 10 | 445-11739-1-ND | C3216JB1V226M160AC | CAP CER 22UF 35V JB 1206 |  | 0 | 356800 | 35,68 zł
