KhazAkar/espws/hw/motherboard/outline.dxf

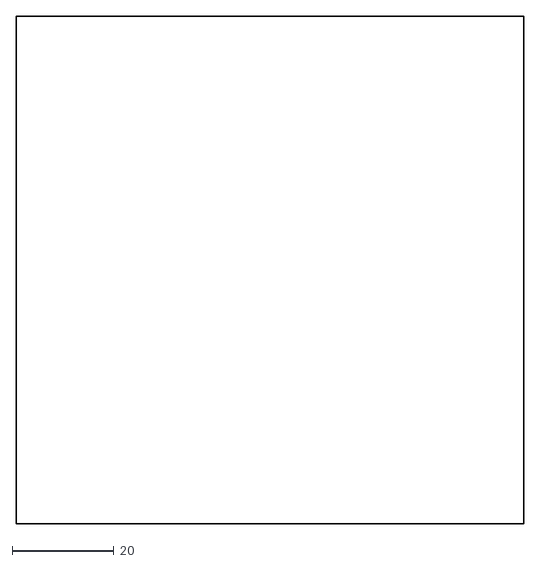
[picture p50: CAD file, 2019-01-31]
hw/motherboard/outline.dxf
100.0 x 100.0
