KhazAkar/espws/thesis/images/sch/sch-whole.pdf

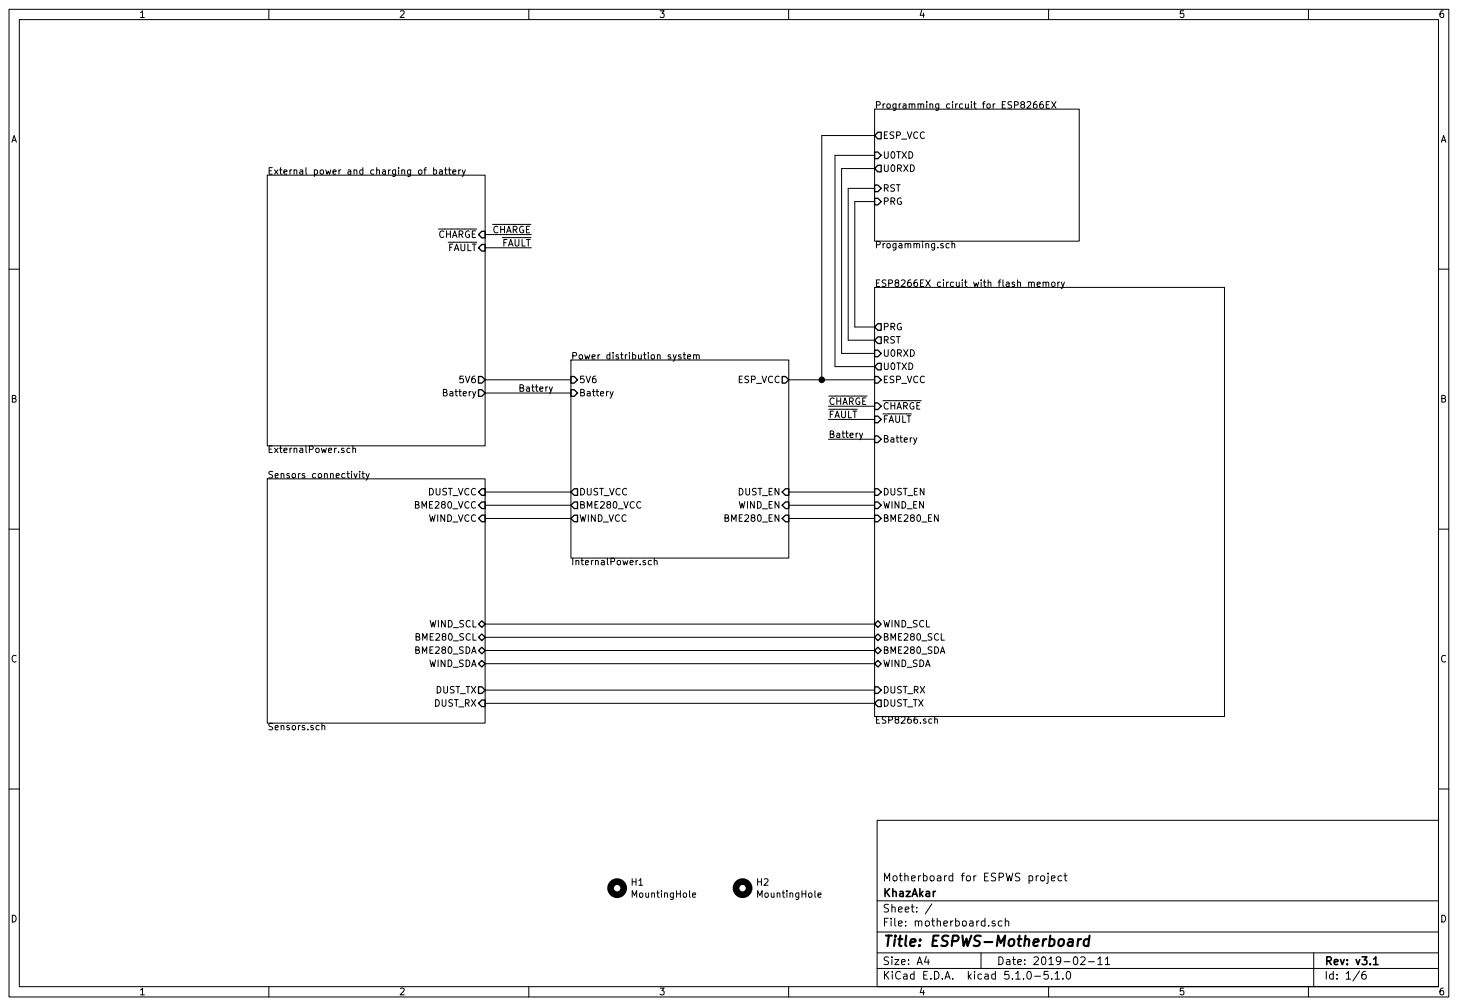
[picture p51: page 1]

External power and charging of battery ExternalPower.sch

Id: 1/6 Title: ESPWS-Motherboard

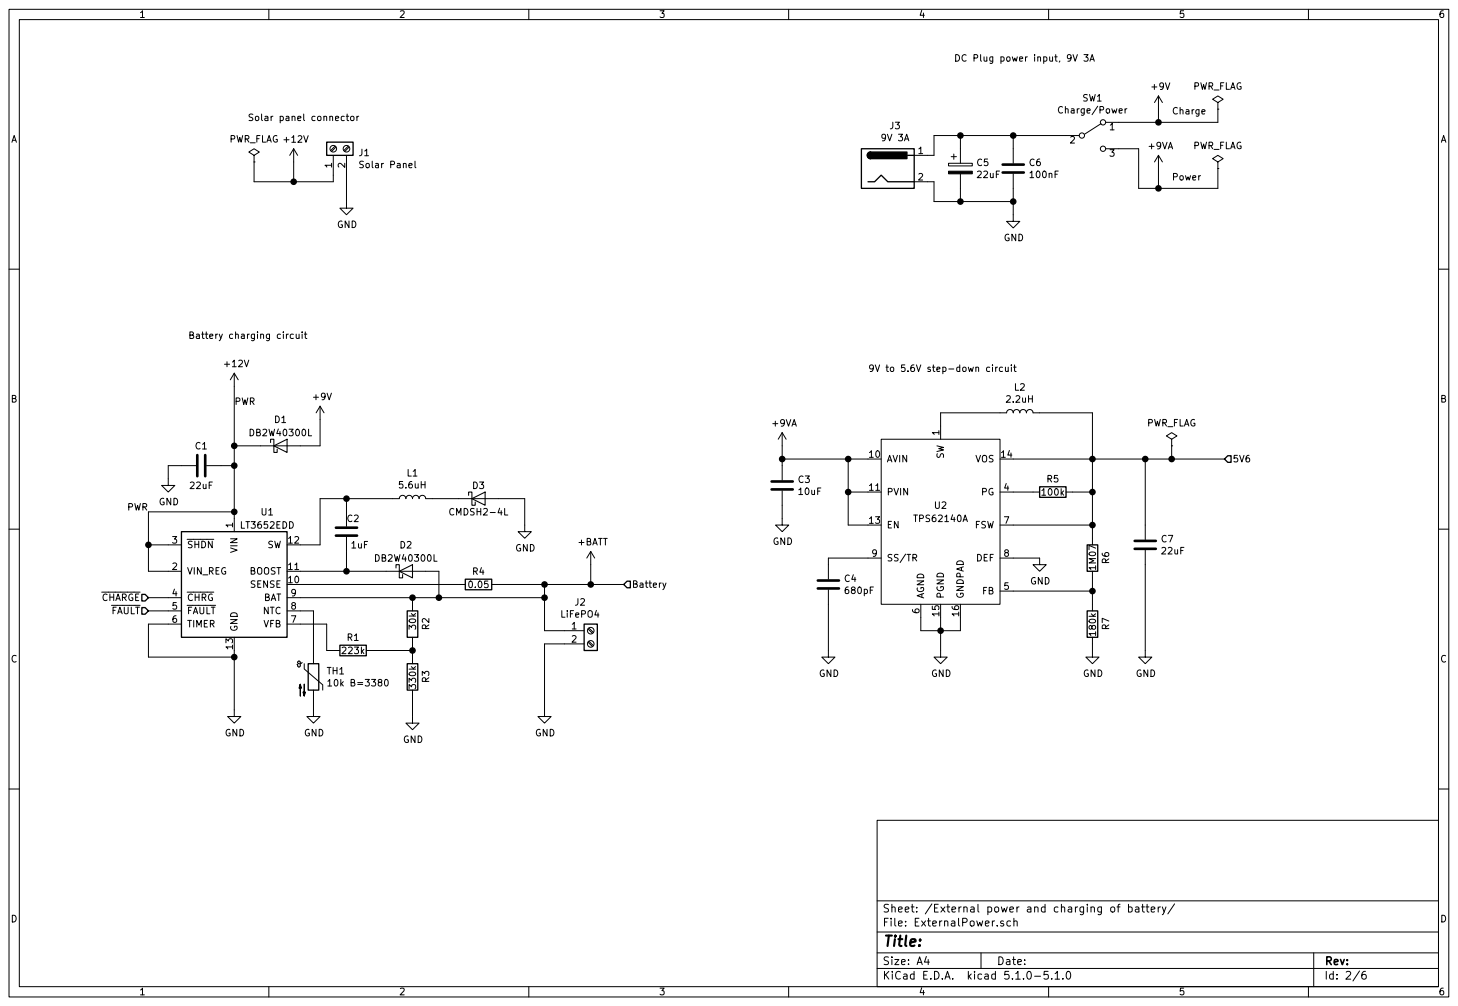
[picture p52: page 2]

22uF DC Plug power input, 9V 3A

9V to 5.6V step-down circuit

1 AVIN 10 PVIN 11 EN 13 VOS 14 PGND 15 GNDPAD 16 PG 4 FB 5 AGND

6 FSW 7 DEF 8 SS/TR 9 U2 TPS62140A R5

1 SENSE 10 BOOST 11 SW 12 GND 13 VIN_REG 2 SHDN 3 CHRG 4 FAULT 5 TIMER 6 VFB 7 NTC 8 BAT 9 U1

Id: 2/6 Title: File: ExternalPower.sch Sheet: /External power and charging of battery/ 1

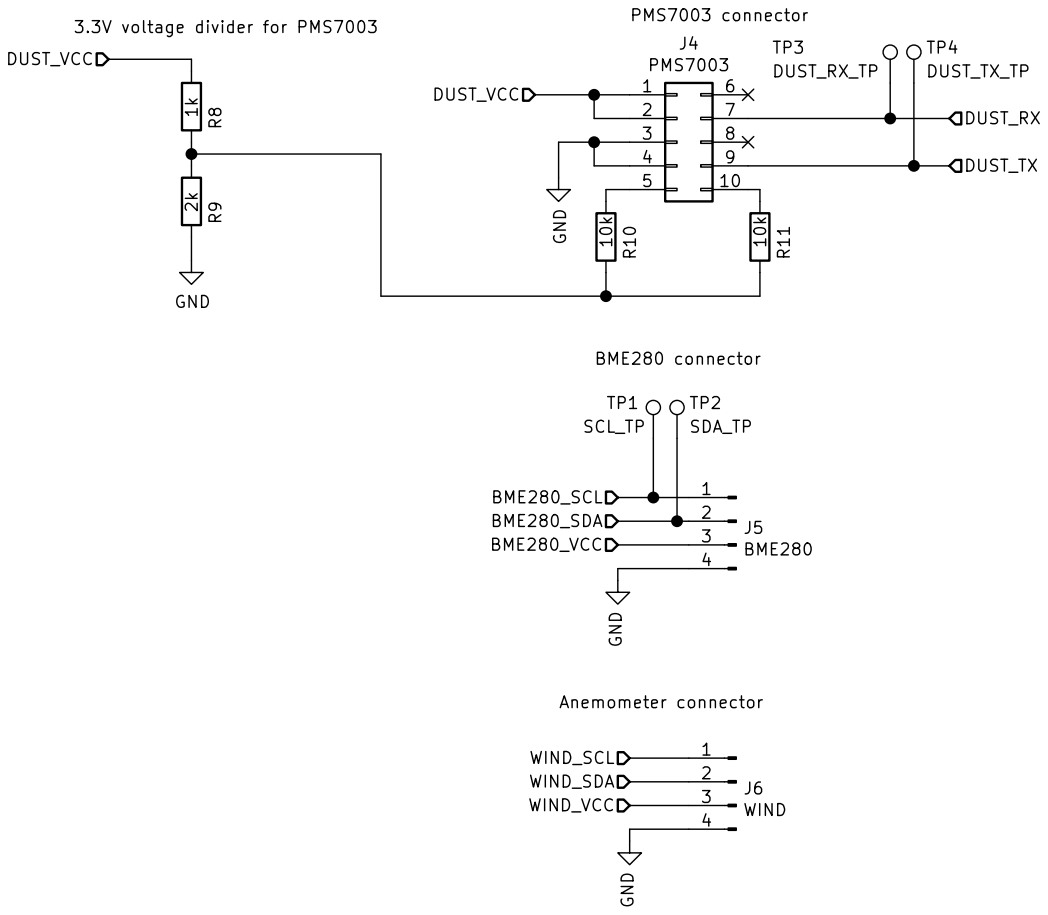
[picture p53: page 3]

Id: 3/6 Title: File: Sensors.sch Sheet: /Sensors connectivity/

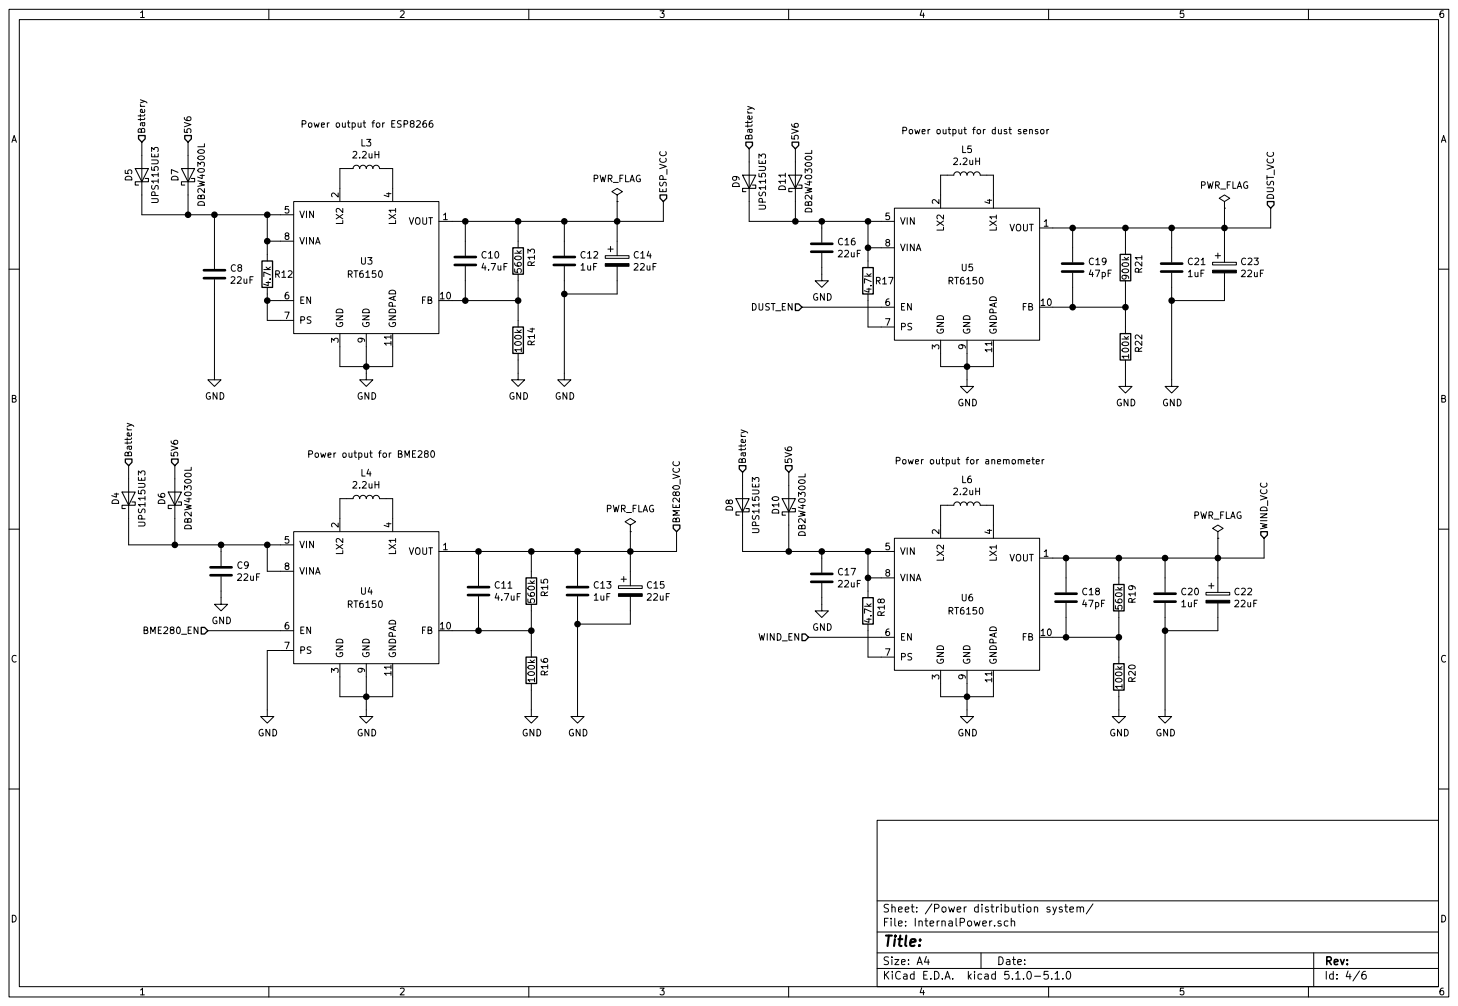
[picture p54: page 4]

Power output for ESP8266 GND
Power output for dust sensor GND R18 4.7k C17

4 VIN 5 EN 6 PS 7 VINA 8 GND

Id: 4/6 Title: File: InternalPower.sch Sheet: /Power distribution system/

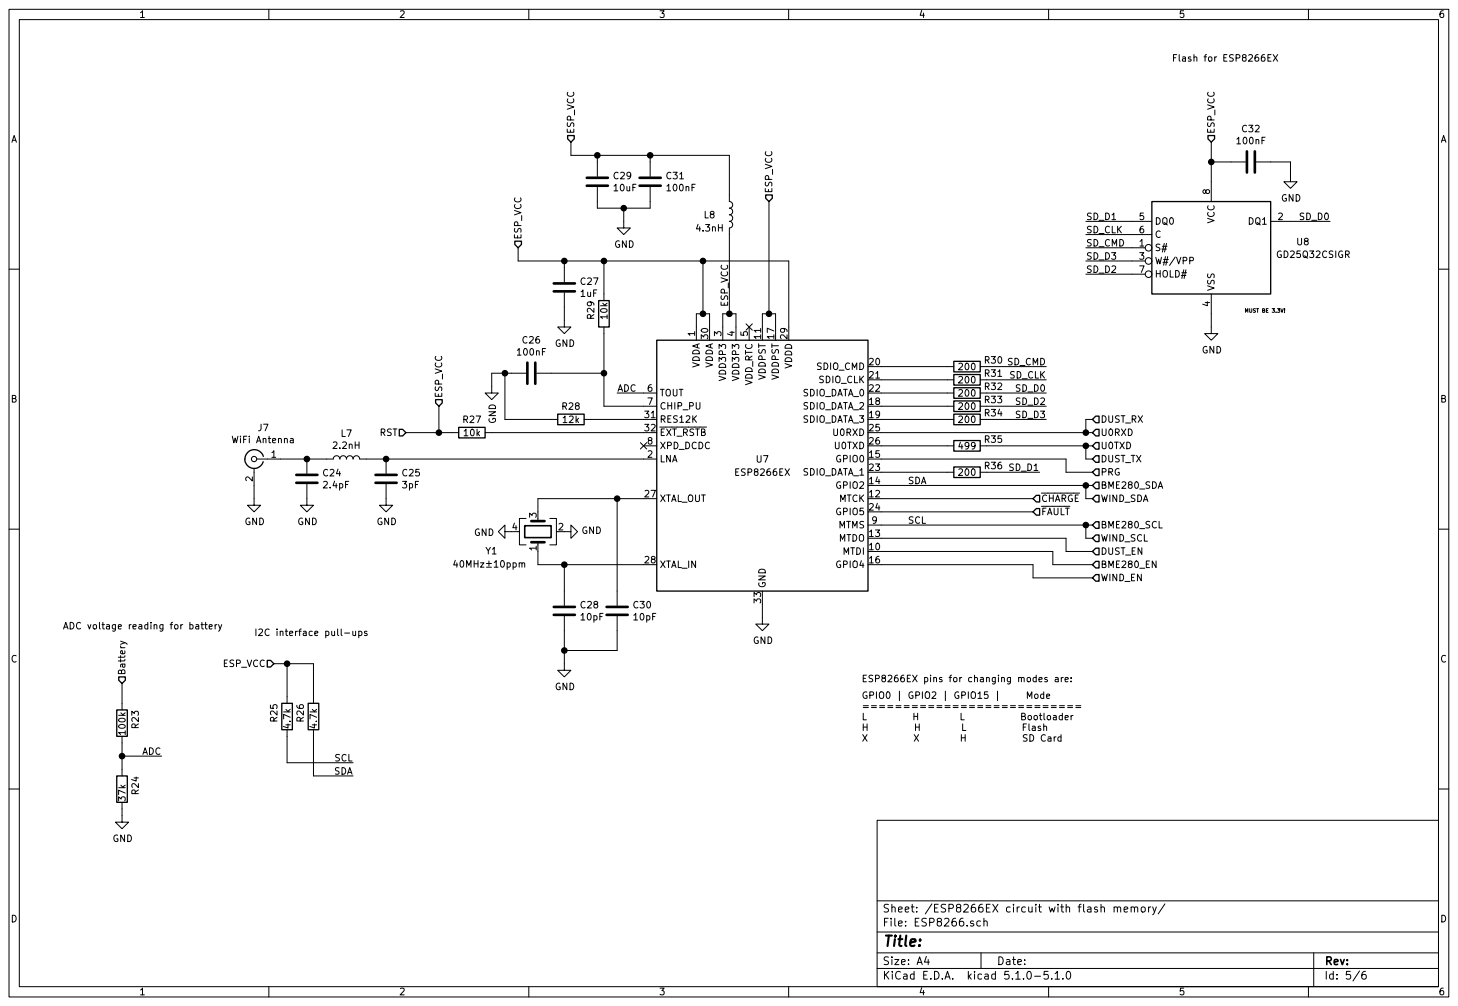
[picture p55: page 5]

1 MTDI 10 VDDPST 11 MTCK 12 MTDO 13 GPIO2 14 GPIO0 15 GPIO4 16 VDDPST 17 SDIO_DATA_2 18 SDIO_DATA_3 19

ADC voltage reading for battery

ESP8266EX pins for changing modes are:
GPIO0 | GPIO2 | GPIO15 | Mode ===========================

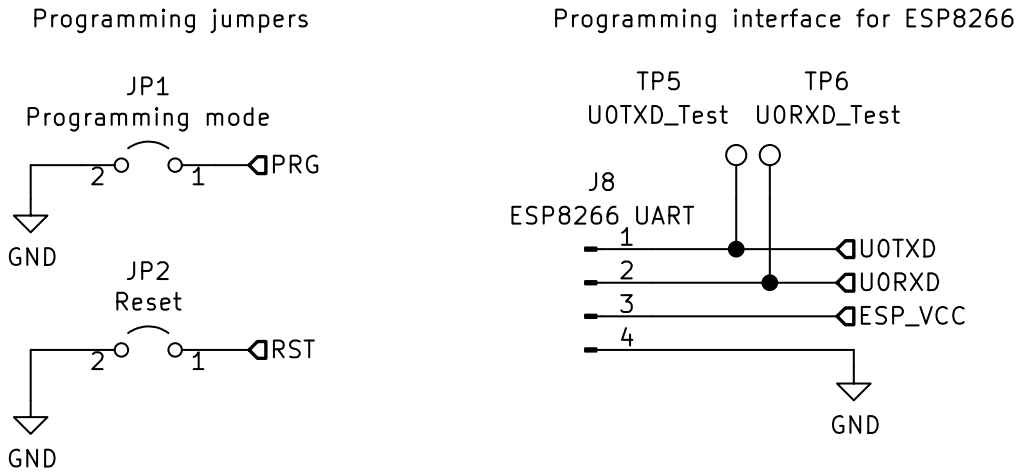
[picture p56: page 6]

Programming interface for ESP8266 PRG

Sheet: /Programming circuit for ESP8266EX/
File: Progamming.sch
Id: 6/6 Title:
