KhazAkar/espws/hw/motherboard/motherboard.kicad_pcb

## KiCad design hw/motherboard/motherboard.kicad_pcb (2019-03-18)

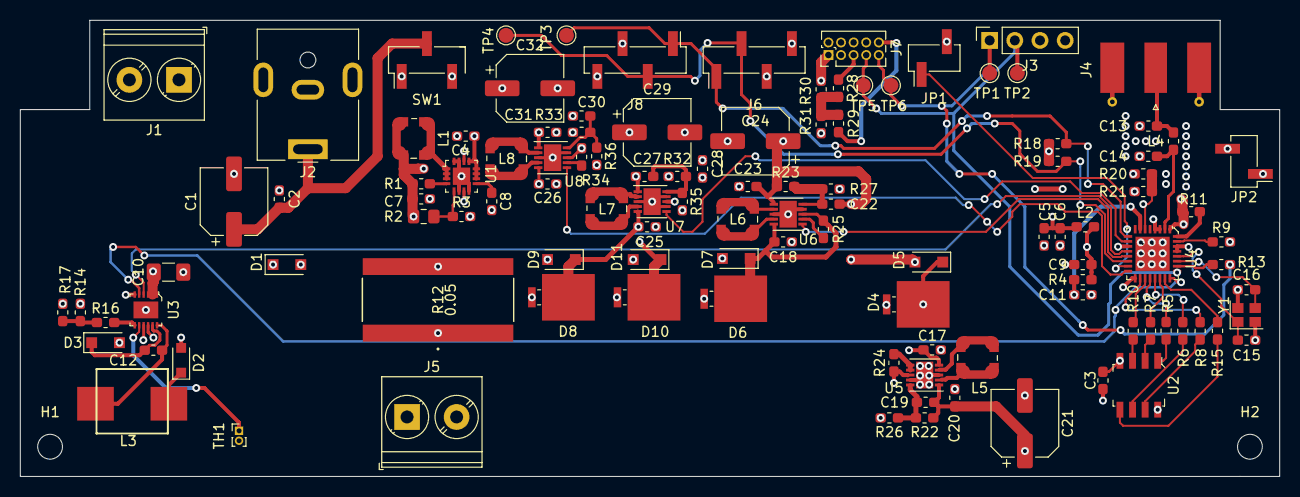
[picture p57: board motherboard.kicad_pcb from above]

Board: 4 copper layers, 127.0 x 46.0 mm, 116 parts (0 on the bottom side), 75 nets.

Parts:
C1, C21, C24, C29, C32: 22uF; CP_Elec_6.3x5.4
C2, C3, C6, C11: 100nF; C_0603_1608Metric_Pad1.05x0.95mm_HandSolder
C4, C5: 10uF; C_0603_1608Metric_Pad1.05x0.95mm_HandSolder
C7, C17, C18, C25, C26: 22uF; C_0603_1608Metric_Pad1.05x0.95mm_HandSolder
C8: 680pF; C_0603_1608Metric_Pad1.05x0.95mm_HandSolder
C9, C20, C23, C28, C31: 1uF; C_0603_1608Metric_Pad1.05x0.95mm_HandSolder
C10: 22uF; C_1206_3216Metric_Pad1.42x1.75mm_HandSolder
C12: 1uF/50V; C_0603_1608Metric_Pad1.05x0.95mm_HandSolder
C13: 2.4pF; C_0603_1608Metric_Pad1.05x0.95mm_HandSolder
C14: 3pF; C_0603_1608Metric_Pad1.05x0.95mm_HandSolder
C15, C16: 10pF; C_0603_1608Metric_Pad1.05x0.95mm_HandSolder
C19, C27: 4.7uF; C_0603_1608Metric_Pad1.05x0.95mm_HandSolder
C22, C30: 47pF; C_0603_1608Metric_Pad1.05x0.95mm_HandSolder
D1, D3, D5, D7, D9, D11: DB2W40300L; D_SOD-123F
D2: CMDSH2-4L; D_SOD-323_HandSoldering
D4, D6, D8, D10: UPS115UE3; D_Powermite2_AK
H1, H2: MountingHole; MountingHole_2.5mm
J1: Solar Panel; TerminalBlock_Phoenix_PT-1,5-2-5.0-H_1x02_P5.00mm_Horizontal
J2: 9V 3A; BarrelJack_CUI_PJ-063AH_Horizontal
J3: ESP8266 UART; PinSocket_1x04_P2.54mm_Vertical
J4: WiFi Antenna; SMA_Molex_73251-1153_EdgeMount_Horizontal
J5: LiFePO4; TerminalBlock_Phoenix_PT-1,5-2-5.0-H_1x02_P5.00mm_Horizontal
J6: BME280; PinHeader_1x04_P2.54mm_Vertical_SMD_Pin1Left
J7: PMS7003; PinHeader_2x05_P1.27mm_Vertical
J8: WIND; PinHeader_1x04_P2.54mm_Vertical_SMD_Pin1Left
JP1: Programming mode; PinHeader_1x02_P2.54mm_Vertical_SMD_Pin1Left
JP2: Reset; PinHeader_1x02_P2.54mm_Vertical_SMD_Pin1Left
L1, L5, L6, L7, L8: 2.2uH; L_Wuerth_WE-TPC-3816
L2: 4.3nH; L_0603_1608Metric_Pad1.05x0.95mm_HandSolder
L3: 5.6uH; SRP6540
L4: 2.2nH; L_0603_1608Metric_Pad1.05x0.95mm_HandSolder
R1, R20, R26, R27, R35, R36: 100k; R_0603_1608Metric_Pad1.05x0.95mm_HandSolder
R2: 1M07; R_0805_2012Metric_Pad1.15x1.40mm_HandSolder
R3, R22, R32: 180k; R_0603_1608Metric_Pad1.05x0.95mm_HandSolder
R4, R11, R28, R29: 10k; R_0603_1608Metric_Pad1.05x0.95mm_HandSolder
R5, R6, R7, R8, R10, R15: 200; R_0603_1608Metric_Pad1.05x0.95mm_HandSolder
R9: 12k; R_0603_1608Metric_Pad1.05x0.95mm_HandSolder
R12: 0.05; FCSL150R050FER
R13: 499; R_0603_1608Metric_Pad1.05x0.95mm_HandSolder
R14: 30k; R_0603_1608Metric_Pad1.05x0.95mm_HandSolder
R16: 223k; R_0603_1608Metric_Pad1.05x0.95mm_HandSolder
R17: 330k; R_0603_1608Metric_Pad1.05x0.95mm_HandSolder
R18, R19, R31: 2k; R_0603_1608Metric_Pad1.05x0.95mm_HandSolder
R21: 37k; R_0603_1608Metric_Pad1.05x0.95mm_HandSolder
R23, R33: 150k; R_0603_1608Metric_Pad1.05x0.95mm_HandSolder
R24, R25, R34: 4.7k; R_0603_1608Metric_Pad1.05x0.95mm_HandSolder
R30: 1k; R_0603_1608Metric_Pad1.05x0.95mm_HandSolder
SW1: Charge/Power; PinHeader_1x03_P2.54mm_Vertical_SMD_Pin1Left
TH1: 10k B=3380; PinHeader_1x02_P1.00mm_Vertical
TP1: U0TXD_Test; TestPoint_Pad_D1.5mm
TP2: U0RXD_Test; TestPoint_Pad_D1.5mm
TP3: SCL_TP; TestPoint_Pad_D1.5mm
TP4: SDA_TP; TestPoint_Pad_D1.5mm
TP5: DUST_RX_TP; TestPoint_Pad_D1.5mm
TP6: DUST_TX_TP; TestPoint_Pad_D1.5mm
U1: TPS62140A; VFQFN-16-1EP_3x3mm
U2: GD25Q32CSIGR; SOIC-8_W5.3mm
U3: LT3652EDD; DFN-12-1EP_3x3mm
U4: ESP8266EX; QFN-32-1EP_5x5mm
U5, U6, U7, U8: RT6150; DFN-10-1EP_3x3mm_P0.5mm_EP1.75x2.7mm
Y1: 40MHz±10ppm; Crystal_SMD_2520-4Pin_2.5x2.0mm

Connections:
5V6: C7.1, D5.2, D7.2, D9.2, D11.2, L1.2, R1.1, R2.1, U1.7, U1.14
+9V: D1.2, SW1.1
+9VA: C4.1, SW1.3, U1.10, U1.11, U1.12, U1.13
+12V: C10.1, D1.1, J1.1, U3.1, U3.2, U3.3
+BATT: D3.2, D4.2, D6.2, D8.2, D10.2, J5.1, R12.1, R14.1, R20.1, U3.9
ADC: R20.2, R21.1, U4.6
BME280_EN: U4.10, U7.6
BME280_SCL: J6.1, J8.1, R18.2, TP3.1, U4.9
BME280_SDA: J6.2, J8.2, R19.2, TP4.1, U4.14
BME280_VCC: C27.1, C28.1, C29.1, J6.3, R32.1, U7.1
DUST_3V3: R28.2, R29.2, R30.2, R31.1
DUST_EN: U4.13, U6.6
DUST_RX: J3.2, J7.7, TP2.1, TP5.1, U4.25
DUST_TX: J3.1, J7.9, R13.1, TP1.1, TP6.1
DUST_VCC: C22.1, C23.1, C24.1, J7.1, J7.2, R23.1, R30.1, U6.1
ESP_VCC: C3.2, C5.1, C6.1, C9.1, C19.1, C20.1, C21.1, J3.3, JP2.2, L2.1, L2.2, R4.1, R11.2, R18.1, R19.1, R22.1, U2.8, U4.1, U4.3, U4.4, U4.11, U4.17, U4.29, U4.30, U5.1
GND: C1.2, C2.2, C3.1, C4.2, C5.2, C6.2, C7.2, C8.2, C9.2, C10.2, C11.2, C13.2, C14.2, C15.2, C16.2, C17.2, C18.2, C20.2, C21.2, C23.2, C24.2, C25.2, C26.2, C28.2, C29.2, C31.2, C32.2, D2.2, J1.2, J2.2, J3.4, J4.2, J5.2, J6.4, J7.3, J7.4, J8.4, JP1.2, JP2.1, R3.2, R9.2, R17.2, R21.2, R26.2, R27.2, R31.2, R35.2, R36.2, TH1.2, U1.6, U1.8, U1.15, U1.16, U1.17, U2.4, U3.6, U3.13, U4.33, U5.3, U5.9, U5.11, U6.3, U6.9, U6.11, U7.3, U7.7, U7.9, U7.11, U8.3, U8.9, U8.11, Y1.2, Y1.4
unnamed: C1.1, C2.1, J2.1, SW1.2
unnamed: C8.1, U1.9
unnamed: C11.1, R4.2, U4.7
unnamed: C12.1, L3.1, U3.12
unnamed: C12.2, D3.1, U3.11
unnamed: C13.1, J4.1, L4.1
unnamed: C14.1, L4.2, U4.2
unnamed: C15.1, U4.28, Y1.1
unnamed: C16.1, U4.27, Y1.3
unnamed: C17.1, D4.1, D5.1, R24.1, U5.5, U5.8
unnamed: C18.1, D6.1, D7.1, R25.1, U6.5, U6.8
unnamed: C19.2, R22.2, R26.1, U5.10
unnamed: C22.2, R23.2, R27.1, U6.10
unnamed: C25.1, D8.1, D9.1, U7.5, U7.8
unnamed: C26.1, D10.1, D11.1, R34.1, U8.5, U8.8
unnamed: C27.2, R32.2, R35.1, U7.10
unnamed: C30.2, R33.2, R36.1, U8.10
unnamed: D2.1, L3.2
unnamed: J7.5, R28.1
unnamed: J7.10, R29.1
unnamed: L1.1, U1.1, U1.2, U1.3
unnamed: L5.1, U5.2
unnamed: L5.2, U5.4
unnamed: L6.1, U6.2
unnamed: L6.2, U6.4
unnamed: L7.1, U7.2
unnamed: L7.2, U7.4
unnamed: L8.1, U8.2
unnamed: L8.2, U8.4
unnamed: R1.2, U1.4
unnamed: R2.2, R3.1, U1.5
unnamed: R5.2, U4.20
unnamed: R6.2, U4.21
unnamed: R7.2, U4.22
unnamed: R8.2, U4.18
unnamed: R9.1, U4.31
unnamed: R10.2, U4.19
unnamed: R11.1, U4.32
unnamed: R12.2, U3.10
unnamed: R13.2, U4.26
unnamed: R14.2, R16.1, R17.1
unnamed: R15.2, U4.23
unnamed: R16.2, U3.7
unnamed: R24.2, U5.6, U5.7
unnamed: R25.2, U6.7
unnamed: R34.2, U8.7
unnamed: TH1.1, U3.8
PRG: JP1.1, U4.15
SD_CLK: R6.1, U2.6
SD_CMD: R5.1, U2.1
SD_D0: R7.1, U2.2
SD_D1: R15.1, U2.5
SD_D2: R8.1, U2.7
SD_D3: R10.1, U2.3
WIND_EN: U4.16, U8.6
WIND_VCC: C30.1, C31.1, C32.1, J8.3, R33.1, U8.1
~CHARGE: U3.4, U4.12
~FAULT: U3.5, U4.24
