KhazAkar/espws/hw/anemometer/anemometer.kicad_pcb

## KiCad design hw/anemometer/anemometer.kicad_pcb (2019-03-05)

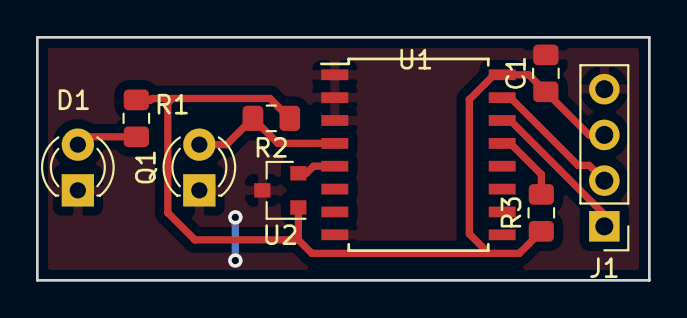
[picture p58: board anemometer.kicad_pcb from above]

Board: 2 copper layers, 34.0 x 13.5 mm, 9 parts (0 on the bottom side), 8 nets.

Parts:
C1: 100nF; C_0805_2012Metric_Pad1.15x1.40mm_HandSolder
D1: TSAL4400; LED_D3.0mm_IRBlack
J1: Connector for motherboard; PinHeader_1x04_P2.54mm_Vertical
Q1: LL-304PTC4B-1AD; LED_D3.0mm_Clear
R1: 39; C_0805_2012Metric_Pad1.15x1.40mm_HandSolder
R2: 10k; C_0805_2012Metric_Pad1.15x1.40mm_HandSolder
R3: 2k; C_0805_2012Metric_Pad1.15x1.40mm_HandSolder
U1: PCF8574; SOIC-16W_7.5x10.3mm_P1.27mm
U2: SS360PT; SOT-23

Connections:
+3V3: C1.1, J1.3, R1.1, R2.1, R3.1, U1.16, U2.1
/HALL_OUT: U1.5, U2.2
/IR_OUT: Q1.2, R2.2, U1.4
GND: C1.2, D1.1, J1.4, Q1.1, U1.1, U1.2, U1.3, U1.8, U2.3
unnamed: D1.2, R1.2
unnamed: J1.1, U1.14
unnamed: J1.2, U1.15
unnamed: R3.2, U1.13
