KhazAkar/espws/(commit log)

2018-11-19 KiCAD project placeholders
    [humidity-sensor.kicad_pcb, humidity-sensor.sch, motherboard.kicad_pcb, motherboard.sch, temperature-sensor.kicad_pcb, temperature-sensor.sch, wind-sensors.kicad_pcb, wind-sensors.sch]
2018-11-19 Fix typo in comment.
    [main.c]
2018-11-19 Add hierarchical schematics to main motherboard schematic file.
    [ISP.sch, Interconnections.sch, MainLogic.sch, PowerSupply.sch, motherboard.sch]
2018-11-21 Add placeholder for 3D model, minor change in electronic schematics arragement.
    [3dmodel.FCStd, BatteryPackAndRecharge.sch, Interconnections.sch, MainLogic.sch, PowerSupply.sch, motherboard.sch]
2018-11-22 Added new functions to makefile and placeholders for additional drivers.
2018-11-25 Make battery slot with real battery measurings + space for cable management and connectivity between battery and mainboard
    [project.dxf]
2018-11-25 WIP with battery charger
    [BatteryPackAndRecharge.sch, ISP.sch, Interconnections.sch, MainLogic.sch, PowerSupply.sch, motherboard.sch]
2018-11-25 Add another module and placeholder for battery driver using ATTiny2313
    [air-quality-sensor.kicad_pcb, air-quality-sensor.sch]
2018-11-25 Fix in main Makefile and slight change in main.c file for ATTiny2313
    [main.c]
2018-11-26 Remove unnecessary wpa2 driver, add drivers for i2c and spi
2018-11-26 Change concept about hardware design.
    [AdvancedPowerSupply.sch, BatteryPackAndRecharge.sch, ISP.sch, Interconnections.sch, MainLogic.sch, motherboard.sch]
2018-11-26 Slight change and my thoughts
    [AdvancedPowerSupply.sch, ISP.sch, Interconnections.sch, MainLogic.sch, motherboard.sch]
2018-11-28 Little redesign and choose MCU for power supply/battery charger.
    [AdvancedPowerSupply.sch, ISP.sch, Interconnections.sch, MainLogic.sch, motherboard.sch]
2018-11-28 Add placeholder code and change from battery driver to advanced power supply
2018-12-03 Start of writing custom Makefile, edit main.c and schematic for P.S
    [AdvancedPowerSupply.sch]
2018-12-04 Add concept for power supply, edit some C files and try to debug.
    [AdvancedPowerSupply.sch]
2018-12-09 Custom libraries, power supply schematics changes, AVR code changes.
    [AdvancedPowerSupply.sch, MainLogic.sch]
2018-12-22 HUUUUGE general changes, need to organise that crap.
    [Interconnections.sch, air-quality-sensor.sch, basic-sensors-module.kicad_pcb, basic-sensors-module.sch, humidity-sensor.kicad_pcb, humidity-sensor.sch, project.dxf, temperature-sensor.kicad_pcb]
2019-01-06 Some random changes
    [3dmodel.FCStd, AdvancedPowerSupply.sch, ISP.sch, Interconnections.sch, MainLogic.sch]
2019-01-07 Add flash chip for ESP, little more work toward the end
    [AdvancedPowerSupply.sch, ISP.sch, MainLogic.sch, motherboard.sch]
2019-01-13 Still working on schematics, much closer to end.
    [AdvancedPowerSupply.sch, ISP.sch, Interconnections.sch, MainLogic.sch, motherboard.sch]
2019-01-15 Mainly changing naming scheme for sensors and other components
    [AdvancedPowerSupply.sch, ISP.sch, Interconnections.sch, MainLogic.sch, motherboard.sch]
2019-01-25 Total reorganization, complete redo of schematics
    [3dmodel.FCStd, AdvancedPowerSupply.sch, ISP.sch, Interconnections.sch, MainLogic.sch, basic-sensors-module.kicad_pcb, basic-sensors-module.sch, motherboard.sch]
2019-01-27 Slight changes in schematics, added thesis folder for project.
    [motherboard.sch]
2019-01-31 Start anemometer project, little add up to thesis and start of PCB.
    [motherboard.sch, outline.dxf, ultrasonic-anemometer.kicad_pcb, ultrasonic-anemometer.sch]
2019-02-05 Fix miniorities in schematics, little more pcb element placement.
    [motherboard.kicad_pcb, motherboard.sch]
2019-02-05 Add test points for some measurements to troubleshoot circuit.
    [motherboard.kicad_pcb, motherboard.sch]
2019-02-05 Same update
    [motherboard.sch]
2019-02-06 New update from new system (Debian)
    [motherboard.kicad_pcb, motherboard.sch, outline.dxf, ultrasonic-anemometer.kicad_pcb, ultrasonic-anemometer.sch]
2019-02-08 Cleanup in code, add libraries and cleanup footprints connections etc.
2019-02-08 Changes in code, added libraries and updated schematics a little.
    [motherboard.kicad_pcb, motherboard.sch]
2019-02-11 Add diagram(need to be updated) and schematic overhaul + new symbol.
    [motherboard.sch]
2019-02-14 Custom footrpints, start of making PCB layout.
    [motherboard.kicad_pcb, motherboard.sch]
2019-02-14 First attempt to layout, fix in footprints a little
    [motherboard.kicad_pcb, motherboard.sch]
2019-02-16 Change outline and mounting holes to match Kradex Z4 enclosure
    [motherboard.kicad_pcb, motherboard.sch]
2019-02-18 More work on thesis and code, less on PCB
    [motherboard.kicad_pcb, motherboard.sch]
2019-02-19 Little more PCB routing + minor fixes to the thesis
    [motherboard.kicad_pcb]
2019-02-20 More PCB layout, hard AF,really
    [motherboard.kicad_pcb]
2019-02-23 PCB done, slight change in schematic.
    [motherboard.kicad_pcb, motherboard.sch]
2019-03-04 Archive footprints, create anemometer schematic and slight changes to the code.
    [BOM-DIgiKey.xlsx, anemometer.kicad_pcb, anemometer.sch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]
2019-03-05 Update from new system - OpenSUSE Tumbleweed
    [BOM-DIgiKey.xlsx, anemometer.kicad_pcb, anemometer.sch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]
2019-03-12 HUGE update to the thesis and minor changes in gerbers
    [motherboard-B.Mask.gbs, motherboard-B.Paste.gbp, motherboard-B.SilkS.gbo, motherboard-Edge.Cuts.gm1, motherboard-F.Mask.gts, motherboard-F.Paste.gtp, motherboard-F.SilkS.gto, motherboard-NPTH-drl.gbr]
2019-03-18 HUGE update to the thesis, re-do diagram, change from C SDK to Arduino.
    [motherboard-B.Mask.gbs, motherboard-B.Paste.gbp, motherboard-B.SilkS.gbo, motherboard-B_Mask.gbr, motherboard-B_Paste.gbr, motherboard-B_SilkS.gbr, motherboard-Edge.Cuts.gm1, motherboard-Edge_Cuts.gbr]
2019-03-24 HUGE update to the thesis, add PDF schematic and more!
    [motherboard.sch]
2019-03-26 Mayby repaired that git this time.
    [ESP8266.sch, ExternalPower.sch, InternalPower.sch, Powersch.sch, Progamming.sch, Programming.sch, Sensors.sch, motherboard.sch]
